neilextraacount-create/holoween-shoot/conveyor/simple/slice-report.md

# Slicer check, every part alone (PrusaSlicer engine, P2S-like profile)

| Part | Qty | Walls | Infill | g each | Time each | Slicer alerts |
|---|---|---|---|---|---|---|
| `head_frame` | 1 | 2 | 10 % | 124 | 3h 39m 44s | none |
| `drive_roller` | 1 | 2 | 10 % | 69 | 4h 10m 44s | none |
| `journal_pin` | 2 | 3 | 100 % | 5 | 16m 34s | none |
| `crank_gear` | 1 | 2 | 10 % | 18 | 38m 56s | none |
| `crank_arm` | 1 | 3 | 15 % | 34 | 1h 2m 1s | Floating object part, Floating bridge anchors |
| `crank_pin` | 1 | 3 | 100 % | 5 | 10m 27s | none |
| `tail_frame` | 1 | 2 | 10 % | 177 | 5h 12m 17s | Collapsing overhang, Thin fragile part |
| `tail_roller` | 1 | 2 | 10 % | 33 | 1h 15m 15s | Long bridging extrusions |
| `wedge` | 2 | 3 | 100 % | 13 | 14m 35s | none |
| `cassette` | 3 | 2 | 10 % | 64 | 1h 54m 37s | Low bed adhesion, Long bridging extrusions |
| `station_stake_1` | 1 | 3 | 15 % | 31 | 35m 37s | none |
| `station_stake_2` | 1 | 3 | 15 % | 29 | 33m 24s | none |
| `station_stake_3` | 1 | 3 | 15 % | 27 | 31m 11s | none |
| `anchor_stake` | 4 | 3 | 15 % | 25 | 32m 21s | none |

Whole machine: **0.87 kg**, about **27 h** (parts one at a time; plates save some time).
