neilextraacount-create/holoween-shoot/conveyor/cad/slice-report.md

# Slicer check (PrusaSlicer engine, P2S-like profile)

Generated by `cad/slice_all.py`. Each part sliced alone with its walls, infill and layer height;
brim 5 mm where the printing guide says. Alerts are the slicer's own stability analysis.

| Part | Qty | Layer | g each | Time each | Slicer alerts |
|---|---|---|---|---|---|
| `test_coupon` | 1 | 0.2 | 53 | 1h 30m 52s | Low bed adhesion, Loose extrusions |
| `wheel_unit` | 6 | 0.2 | 23 | 58m 31s | none |
| `station_bracket` | 3 | 0.2 | 15 | 23m 28s | none |
| `stake_1` | 1 | 0.2 | 34 | 37m 8s | Long bridging extrusions |
| `stake_2` | 1 | 0.2 | 32 | 34m 47s | Long bridging extrusions |
| `stake_3` | 1 | 0.2 | 29 | 32m 37s | Long bridging extrusions |
| `drive_roller` | 1 | 0.16 | 84 | 5h 3m 1s | none |
| `drive_pin` | 1 | 0.2 | 5 | 16m 34s | none |
| `head_side_a` | 1 | 0.2 | 45 | 1h 9m 30s | none |
| `head_side_b` | 1 | 0.2 | 54 | 1h 26m 4s | none |
| `gearbox` | 1 | 0.16 | 95 | 3h 18m 43s | Low bed adhesion |
| `trap` | 1 | 0.2 | 33 | 1h 18m 48s | none |
| `foot` | 3 | 0.2 | 23 | 36m 22s | none |
| `tail_side_l` | 1 | 0.2 | 44 | 1h 13m 37s | none |
| `tail_side_r` | 1 | 0.2 | 44 | 1h 12m 40s | none |
| `tail_roller` | 1 | 0.16 | 46 | 1h 33m 46s | Low bed adhesion |
| `takeup_block` | 2 | 0.2 | 13 | 25m 19s | none |
| `takeup_nut` | 2 | 0.2 | 2 | 5m 1s | none |
| `takeup_screw` | 2 | 0.2 | 12 | 50m 31s | none |
| `skid_l` | 1 | 0.2 | 32 | 48m 40s | none |
| `skid_r` | 1 | 0.2 | 32 | 48m 40s | none |
| `chute_segment` | 5 | 0.2 | 91 | 3h 8m 22s | none |
| `crank_head` | 1 | 0.2 | 116 | 3h 11m 26s | Low bed adhesion |
| `crank_arm` | 1 | 0.2 | 45 | 1h 29m 42s | Floating object part, Collapsing overhang |
| `pin3` | 12 | 0.2 | 0 | 1m 50s | none |
| `splice_template` | 1 | 0.2 | 13 | 27m 25s | none |
| `stand_shim` | 4 | 0.2 | 3 | 4m 25s | none |
| `hex_coupler` | 7 | 0.2 | 3 | 6m 8s | none |
| `ring_sleeve` | 6 | 0.2 | 2 | 3m 41s | none |
| `post_lower` | 1 | 0.2 | 46 | 53m 27s | Floating bridge anchors, Long bridging extrusions |
| `post_upper` | 1 | 0.2 | 35 | 51m 50s | none |
| `stand_tray` | 1 | 0.2 | 29 | 45m 32s | none |
| `ground_screw` | 4 | 0.2 | 24 | 1h 16m 40s | none |
| `spike` | 4 | 0.2 | 17 | 22m 3s | none |
| `stake_cap` | 1 | 0.2 | 6 | 16m 24s | none |
| `gs_wrench` | 1 | 0.2 | 21 | 35m 32s | none |
| `bolt8_28` | 17 | 0.2 | 2 | 14m 51s | none |
| `nut8` | 13 | 0.2 | 1 | 3m 31s | none |
| `washer50` | 4 | 0.2 | 7 | 8m 9s | none |

Machine total (test coupon excluded): **1.97 kg**, about **70 h** of printing (PrusaSlicer's estimate with Bambu-like speeds; parts sliced one at a time, so plates of several parts save some time).
