neilextraacount-create/holoween-shoot/conveyor/calc/report-2-risers.txt

==============================================================================
CANDY CONVEYOR v4 (all printed except the belt) - 2 risers x 7.00 in (riser height ASSUMED)
==============================================================================
Porch floor 35.9 in above the sidewalk; lawn rises 21.9 in over 250 in
Belt: drive roller at x=240 in (10 in before the first riser), belt top 6.0 in above the lawn
      tail roller at x=-2 in (over the sidewalk), belt top 9.0 in -> basket rim <= 6.0 in
      slope 4.25 deg; axle to axle 6164 mm (20.22 ft)

STAKE STATIONS (3, every 60.5 in)
   #    x in  ground  belt top  stake head  stake length  stake_len (leg)
   1    58.5     5.1       8.4       5.1 in       280 mm          248 mm  (STL: stake_1)
   2   119.0    10.4       7.6       4.3 in       260 mm          228 mm  (STL: stake_2)
   3   179.5    15.7       6.8       3.5 in       240 mm          208 mm  (STL: stake_3)
  -> stake_len = [248, 228, 208] in params.scad (leg lengths; each stake is 32 mm longer overall)

DRIVE LINE (chute + shaft) at 40.3 deg to level, from the drive axle up to the porch
  4 segments: crank 18.2 in above the porch floor, +3.6 in behind the edge; stand post -2.7 in behind the edge
  5 segments: crank 23.6 in above the porch floor, +9.9 in behind the edge; stand post +3.6 in behind the edge  <- use
  6 segments: crank 28.9 in above the porch floor, +16.2 in behind the edge; stand post +9.9 in behind the edge
  7 segments: crank 34.2 in above the porch floor, +22.5 in behind the edge; stand post +16.2 in behind the edge
  8 segments: crank 39.6 in above the porch floor, +28.8 in behind the edge; stand post +22.5 in behind the edge
  9 segments: crank 44.9 in above the porch floor, +35.1 in behind the edge; stand post +28.8 in behind the edge
  underside over riser 1 top (x=250): 4.4 in
  underside over riser 2 top (x=270): 14.4 in
  -> minimum clearance 4.4 in OK
  porch stand: post 3.6 in behind the porch edge; socket mouth 552 mm above the porch floor -> stand_h = 552 in params.scad

BELT (3 in heavy polypropylene webbing, Country Brook 50 yd)
  Loop about 12493 mm = 41.0 ft; cut 43 ft and sew in place with a 75 mm lap

LOADS (estimates; PLA-on-PLA plain bearings)
  dry PLA  : tail bearing  6.6 N + 6 wheels 1.8 N + bending 2 N = 10.4 N belt drag; slack side 14.8 N; drive needs mu >= 0.17; crank 1.26 N.m = 11 N (2.6 lbf)
  waxed PLA: tail bearing  3.7 N + 6 wheels 1.0 N + bending 2 N =  6.8 N belt drag; slack side 16.6 N; drive needs mu >= 0.11; crank 0.96 N.m = 9 N (2.0 lbf)
  Ribbed PLA on dry webbing is roughly mu 0.3, wet roughly 0.2: grip is adequate; wax the bearings.
  Carrying-run sag between stations (1.54 m, 15 N): light candy 22 mm
  Carrying-run sag between stations (1.54 m, 15 N): dense candy 41 mm
  Tension test, 100 g laid across the belt midway between stations: extra dip 13-15 mm at 25 N, 15-18 mm at 20 N, 17-22 mm at 15 N per run -> target 13-22 mm
  Gap between the top and return runs at a station: 44.6 mm; with dense candy at mid-span about 12 mm
  Crank 45 rpm x 2 -> belt 0.30 m/s; candy rides the belt in 21 s (15 turns)
  Candy leaves a 1.16 m chute at 3.1 m/s (wrapper friction 0.3); the drop trap at the bottom stops it
  Candy leaves a 1.16 m chute at 2.6 m/s (wrapper friction 0.45); the drop trap at the bottom stops it

ANCHORING (belt tension must go into the ground at both ends)
  tail: 40 N pull at 207 mm -> 8.3 N.m; tipping arm 172 mm -> 48 N uplift on the 2 skid anchors nearest the sidewalk (ground screws): 24 N each, or 4.9 kg of ballast against tipping
  head: 40 N pull at 120 mm -> 4.8 N.m; tipping arm 170 mm -> 28 N uplift on the 2 anchors of the foot nearest the steps (ground screws): 14 N each, or 2.9 kg of ballast against tipping
  sliding with ballast only (nothing in the ground; wet grass mu 0.4): head needs 13 kg, tail 8 kg in total -> the ground screws (or spikes) must hold the 40 N; ballast only helps against tipping

PLA STRESS CHECKS (parts printed with layers across the load are the weak case; only the printed walls
  count: 3 walls = a 1.26 mm solid shell on rollers and the gearbox, 2 walls = 0.84 mm on the chute's shaft;
  the 10 % sparse infill inside is ignored)
  tail axle Ø12 (layers across, shell only): 8.7 MPa bending  (PLA interlayer ~20-30 MPa)
  torque path, shear in MPa at the dry crank torque 1.26 / 2x 2.52 / a 30 N yank 3.30 N.m (PLA across layers ~20-30):
    line shaft tube Ø18/10             2.7 /   5.4 /   7.1
    hex coupler 11 mm across flats     5.0 /  10.1 /  13.2
    square drive 12.4 mm               4.0 /   8.1 /  10.6
  gear teeth at 2x dry torque: 45 N tooth force -> 7.6 MPa (Lewis); crown teeth are printed with layers across
  porch stand: about 7 N.m tips the stand sideways when cranking hard -> tie the post to a railing, or about 8 kg on the tray (two 1-gallon water jugs), or hold the funnel rim
  station wheel axle Ø11 (2-wall shell only), 6 N at mid-wheel: 4.8 MPa bending across layers
  crank grip axle Ø13 with a 30 N hand load at mid-grip: 4.9 MPa bending across layers
  crank arm 14 x 7 mm at the hub, 30 N on the grip: 12.7 MPa bending along the layers (PLA ~50)
