neilextraacount-create/holoween-shoot/conveyor/simple/gcode-gaps.md

# Print-in-place gaps in the sliced G-code

| Part | Bodies | Smallest side gap | Printed over another body |
|---|---|---|---|
| `crank_arm` | 2 | 0.43 mm | 2 layer(s) of air |
| `cassette` | 3 | 0.44 mm | never |

Result: all gaps open.
