neilextraacount-create/holoween-shoot/conveyor/plates/plates.md

# Print plates

Generated by `cad/make_plates.py`. Start each plate in a new project (File > New Project) and import
the plate file: Bambu Studio centres an imported plate on the bed and does not move it clear of parts
already there. Choose the P2S, 0.4 mm nozzle, your PLA and the textured PEI plate, set the plate's
walls, infill, layer height and brim as listed, then slice and print.
Grams and times are PrusaSlicer's estimate with a P2S-like profile; Bambu Studio's numbers will differ a little.

| # | File | Parts | For | Settings | g | Time |
|---|---|---|---|---|---|---|
| 1 | `FINAL_01_test_coupon_etc.3mf` | `test_coupon`, `hex_coupler`, `ring_sleeve`, `bolt8_28`, `stake_cap` | test | 3 walls, 15 % | 64 | 1h 53m 47s |
| 2 | `FINAL_02_bolt8_28_etc.3mf` | 7 x `hex_coupler`, 17 x `bolt8_28`, 12 x `pin3`, 2 x `takeup_screw` | head, tail | 3 walls, 100 %, 5 mm brim | 90 | 3h 22m 27s |
| 3 | `FINAL_03_washer50_etc.3mf` | `drive_pin`, 6 x `ring_sleeve`, 13 x `nut8`, 2 x `takeup_block`, 2 x `takeup_nut`, 4 x `washer50`, 4 x `stand_shim`, `splice_template` | head, tail, anchors, porch stand, belt joint | 3 walls, 100 % | 111 | 3h 12m 56s |
| 4 | `FINAL_04_head_side_a_etc.3mf` | `head_side_a`, 2 x `foot`, `station_bracket` | head, station 1 | 3 walls, 12 % | 105 | 2h 46m 20s |
| 5 | `FINAL_05_gearbox_etc.3mf` | `gearbox`, `drive_roller`, `tail_roller` | head, tail | 3 walls, 10 %, 0.16 mm layers | 224 | 9h 58m 22s |
| 6 | `FINAL_06_head_side_b_etc.3mf` | `head_side_b`, `foot`, `spike` | head, tail | 3 walls, 12 % | 94 | 2h 24m 13s |
| 7 | `FINAL_07_wheel_unit.3mf` | 6 x `wheel_unit` | station 1 | 2 walls, 10 %, 5 mm brim | 136 | 4h 26m 38s |
| 8 | `FINAL_08_tail_side_r_etc.3mf` | `station_bracket`, `tail_side_r`, 3 x `spike` | station 1, tail | 3 walls, 12 % | 109 | 2h 31m 20s |
| 9 | `FINAL_09_post_lower_etc.3mf` | `stake_1`, `stake_2`, `post_lower` | station 1, stations 2-3, porch stand | 3 walls, 12 % | 112 | 2h 6m 30s |
| 10 | `FINAL_10_tail_side_l_etc.3mf` | `station_bracket`, `tail_side_l` | station 1, tail | 3 walls, 12 % | 59 | 1h 35m 50s |
| 11 | `FINAL_11_crank_arm_etc.3mf` | `stake_cap`, `crank_arm` | station 1, chute line | 4 walls, 30 % | 52 | 1h 42m 56s |
| 12 | `FINAL_12_skid_l_etc.3mf` | `skid_l`, `skid_r` | tail | 3 walls, 12 % | 64 | 1h 37m 28s |
| 13 | `FINAL_13_gs_wrench_etc.3mf` | `gs_wrench`, 4 x `ground_screw` | anchors | 3 walls, 15 %, 5 mm brim | 116 | 4h 48m 44s |
| 14 | `FINAL_14_post_upper_etc.3mf` | `stake_3`, `post_upper` | stations 2-3, porch stand | 3 walls, 12 % | 64 | 1h 24m 16s |
| 15 | `FINAL_15_chute_segment_etc.3mf` | `trap`, 3 x `chute_segment` | chute line | 2 walls, 10 %, 5 mm brim | 306 | 9h 58m 48s |
| 16 | `FINAL_16_chute_segment.3mf` | 2 x `chute_segment` | chute line | 2 walls, 10 %, 5 mm brim | 182 | 6h 7m 40s |
| 17 | `FINAL_17_crank_head.3mf` | `crank_head` | chute line | 3 walls, 10 %, 5 mm brim | 116 | 3h 11m 21s |
| 18 | `FINAL_18_stand_tray.3mf` | `stand_tray` | porch stand | 3 walls, 12 % | 29 | 45m 34s |

All plates: **2.03 kg** of filament (test coupon plate included).
