neilextraacount-create/holoween-shoot/conveyor/cad/gcode-gaps.md

# Print-in-place gaps in the sliced G-code

Generated by `cad/gcode_gaps.py` from the G-code `slice_all.py` writes. Side gap: the closest
approach of plastic of two different bodies in one layer (lines counted at their full width).
Vertical: a body printed over another one 1 layer below (fused), 2 layers below (0.2 mm of air)
or 3 layers below (0.4 mm).

| Part | Bodies | Smallest side gap | Printed over another body |
|---|---|---|---|
| `test_coupon` | 7 | 0.34 mm (z 2.6) | 2 layer(s) of air at z 4.6 |
| `wheel_unit` | 2 | 0.44 mm (z 58.2) | never |
| `gearbox` | 2 | 0.43 mm (z 15.08) | never |
| `tail_roller` | 2 | 0.44 mm (z 61.48) | never |
| `chute_segment` | 2 | 0.44 mm (z 167.4) | never |
| `crank_head` | 2 | 0.44 mm (z 117.0) | never |
| `crank_arm` | 2 | 0.43 mm (z 7.6) | 2 layer(s) of air at z 7.6 |

Result: all gaps open (side gap must be >= 0.30 mm, nothing printed directly on another body).
