neilextraacount-create/holoween-shoot/conveyor/cad/parts-table.md

| Part (STL) | Qty | Size on the bed, mm | Walls | Infill | Layer | Brim | ~g each (mesh estimate) | What it is |
|---|---|---|---|---|---|---|---|---|
| `test_coupon` | 1 | 150 x 93 x 20 | 3 | 15 % | 0.20 | no | 60 | PRINT FIRST: fit ladder (spinners 0.35/0.45/0.55, sockets, M8 nut) |
| `wheel_unit` | 6 | 30 x 30 x 115 | 2 | 10 % | 0.20 | 5 mm | 21 | station wheel, print-in-place (2 per station) |
| `station_bracket` | 3 | 28 x 109 x 16 | 3 | 12 % | 0.20 | no | 17 | station bracket (holds 2 wheels on the stake) |
| `stake_1` | 1 | 214 x 200 x 22 (diagonal) | 3 | 12 % | 0.20 | no | 37 | station 1 stake (nearest the sidewalk) |
| `stake_2` | 1 | 199 x 186 x 22 (diagonal) | 3 | 12 % | 0.20 | no | 35 | station 2 stake |
| `stake_3` | 1 | 185 x 171 x 22 (diagonal) | 3 | 12 % | 0.20 | no | 32 | station 3 stake |
| `drive_roller` | 1 | 67 x 67 x 122 | 3 | 10 % | 0.16 | no | 93 | drive roller with 17T pinion |
| `drive_pin` | 1 | 20 x 20 x 35 | 3 | 100 % | 0.20 | no | 5 | drive roller A-side journal pin (press in) |
| `head_side_a` | 1 | 206 x 196 x 6 | 3 | 12 % | 0.20 | no | 57 | head side frame A (round journal hole) |
| `head_side_b` | 1 | 237 x 196 x 6 | 3 | 12 % | 0.20 | no | 68 | head side frame B (open journal slot, gearbox mount) |
| `gearbox` | 1 | 92 x 109 x 91 | 3 | 10 % | 0.16 | no | 96 | gearbox: 34T crown gear rotor in its housing, print-in-place |
| `trap` | 1 | 103 x 37 x 152 | 2 | 10 % | 0.20 | 5 mm | 32 | drop trap (bottom of the chute, rests on the head frames) |
| `foot` | 3 | 36 x 196 x 24 | 3 | 12 % | 0.20 | no | 25 | foot crossbar (2 head, 1 tail rear) |
| `tail_side_l` | 1 | 227 x 218 x 28 | 3 | 12 % | 0.20 | no | 54 | tail side frame, left (-Y) |
| `tail_side_r` | 1 | 227 x 218 x 28 | 3 | 12 % | 0.20 | no | 54 | tail side frame, right (+Y) |
| `tail_roller` | 1 | 45 x 45 x 90 | 3 | 10 % | 0.16 | no | 46 | tail roller, print-in-place |
| `takeup_block` | 2 | 22 x 24 x 36 | 3 | 100 % | 0.20 | no | 13 | take-up block (one per side) |
| `takeup_nut` | 2 | 16 x 16 x 8 | 3 | 100 % | 0.20 | no | 2 | take-up square nut |
| `takeup_screw` | 2 | 21 x 22 x 108 | 3 | 100 % | 0.20 | 5 mm | 11 | take-up screw with knob |
| `skid_l` | 1 | 239 x 59 x 24 | 3 | 12 % | 0.20 | no | 37 | tail skid, left |
| `skid_r` | 1 | 239 x 59 x 24 | 3 | 12 % | 0.20 | no | 37 | tail skid, right |
| `chute_segment` | 5 | 166 x 136 x 230 | 2 | 10 % | 0.20 | 5 mm | 113 | chute segment with print-in-place drive shaft |
| `crank_head` | 1 | 185 x 156 x 180 | 3 | 10 % | 0.20 | 5 mm | 142 | crank head: funnel + crank shaft, print-in-place |
| `crank_arm` | 1 | 134 x 26 x 77 | 4 | 30 % | 0.20 | no | 49 | crank arm with spinning grip, print-in-place |
| `pin3` | 12 | 28 x 7 x 5 | 3 | 100 % | 0.20 | 5 mm | 0 | 3 mm pin: wheel pegs (6), crank arm, crank-head socket, stand height, tray, joint between 2 lower posts if any, spares (2) |
| `splice_template` | 1 | 78 x 82 x 6 | 3 | 100 % | 0.20 | no | 13 | belt sewing template (box-and-X hole pattern) |
| `stand_shim` | 4 | 40 x 22 x 3 | 3 | 100 % | 0.20 | no | 3 | shims to level the porch stand foot |
| `hex_coupler` | 7 | 23 x 13 x 11 | 3 | 100 % | 0.20 | 5 mm | 3 | hex coupler between shafts |
| `ring_sleeve` | 6 | 25 x 25 x 8 | 3 | 100 % | 0.20 | no | 2 | sleeve between bearing rings |
| `post_lower` | 1 | 229 x 233 x 22 (diagonal) | 3 | 12 % | 0.20 | no | 51 | porch stand post, lower |
| `post_upper` | 1 | 226 x 226 x 20 (diagonal) | 3 | 12 % | 0.20 | no | 40 | porch stand post, upper |
| `stand_tray` | 1 | 190 x 236 x 32 | 3 | 12 % | 0.20 | no | 34 | porch stand foot (put the candy bowl on it) |
| `ground_screw` | 4 | 26 x 26 x 150 | 3 | 15 % | 0.20 | 5 mm | 24 | ground screw (head front foot, tail skid rear anchors) |
| `spike` | 4 | 134 x 30 x 30 | 3 | 12 % | 0.20 | no | 18 | L spike with nail head: 2 for the tail skid far pads, 2 optional for the head rear foot |
| `stake_cap` | 1 | 22 x 22 x 28 | 4 | 30 % | 0.20 | no | 8 | push the stakes in through this cap |
| `gs_wrench` | 1 | 160 x 33 x 24 | 3 | 15 % | 0.20 | 5 mm | 23 | T-wrench for the ground screws |
| `bolt8_28` | 17 | 13 x 15 x 33 | 3 | 100 % | 0.20 | 5 mm | 2 | printed M8 bolt (13 frame joints + 4 ground screws) |
| `nut8` | 13 | 13 x 15 x 7 | 3 | 100 % | 0.20 | no | 1 | printed M8 nut |
| `washer50` | 4 | 50 x 50 x 3 | 3 | 100 % | 0.20 | no | 7 | 50 mm washer over a ground screw |

Filament for one machine (test coupon excluded): **about 2.20 kg** (estimate from the meshes; your slicer gives the real number).
