neilextraacount-create/holoween-shoot/conveyor/cad/stl/spike.stl

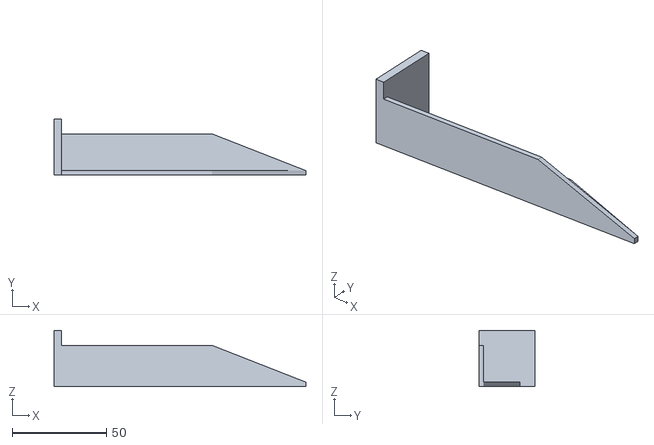
[picture p10: CAD file, 2026-10-14]
conveyor/cad/stl/spike.stl
134.0 x 30.0 x 30.0
