neilextraacount-create/holoween-shoot/conveyor/plates/FINAL_08_tail_side_r_etc.3mf

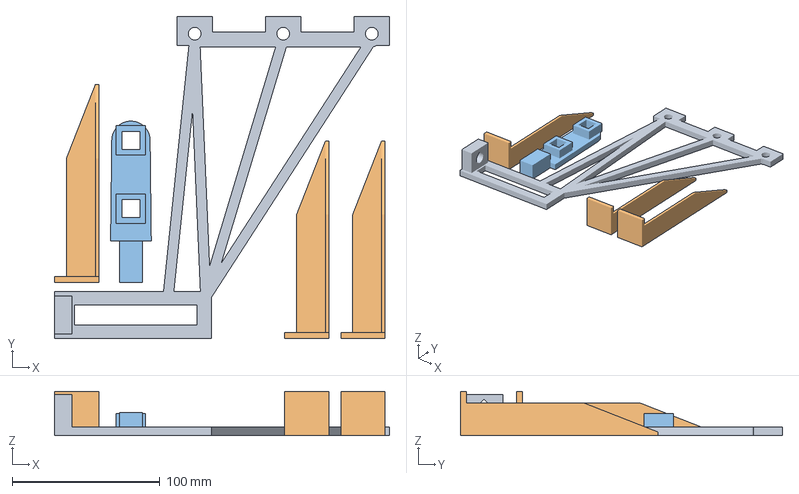
[picture p11: CAD file, 2026-10-14]
conveyor/plates/FINAL_08_tail_side_r_etc.3mf
227.0 x 218.2 x 30.0 mm
tail_side_r
spike x 3
station_bracket
