neilextraacount-create/holoween-shoot/conveyor/simple/plates/SIMPLE_03_head_frame.3mf

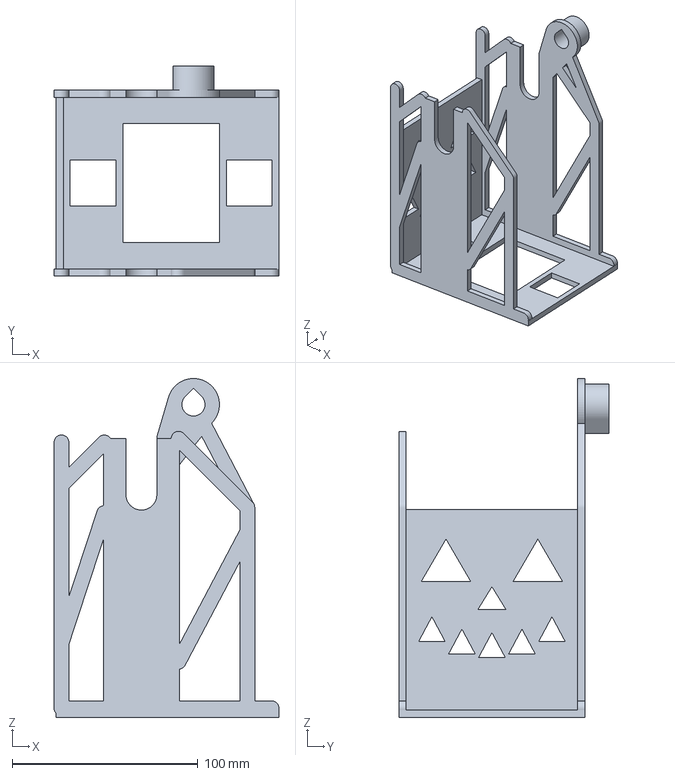
[picture p12: CAD file, 2026-10-16]
conveyor/simple/plates/SIMPLE_03_head_frame.3mf
121.0 x 113.2 x 182.4 mm
