neilextraacount-create/holoween-shoot/conveyor/cad/stl/stake_3.stl

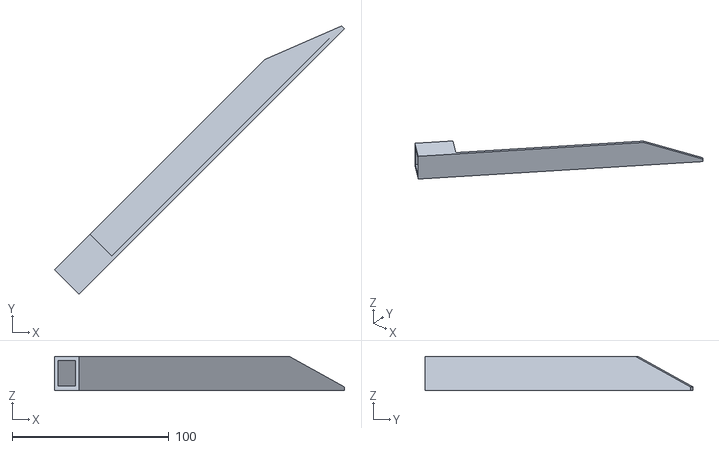
[picture p13: CAD file, 2026-10-14]
conveyor/cad/stl/stake_3.stl
185.3 x 171.4 x 22.0
