neilextraacount-create/holoween-shoot/conveyor/plates/FINAL_17_crank_head.3mf

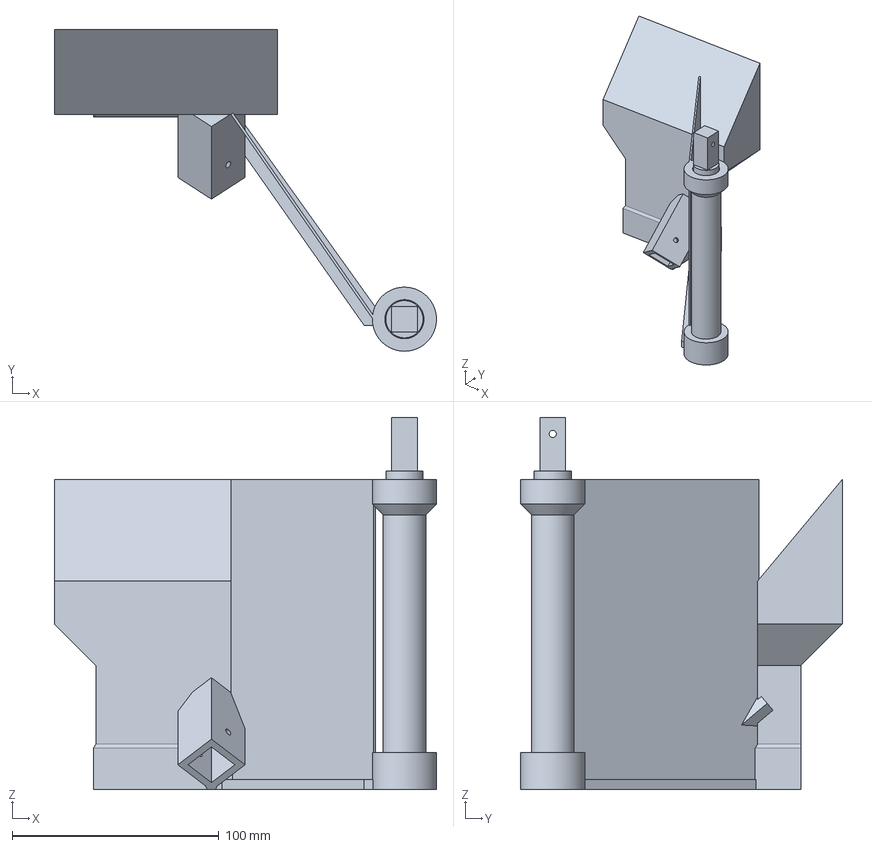
[picture p14: CAD file, 2026-10-14]
conveyor/plates/FINAL_17_crank_head.3mf
184.8 x 155.5 x 180.0 mm
