neilextraacount-create/holoween-shoot/conveyor/simple/plates/SIMPLE_04_cassette_etc.3mf

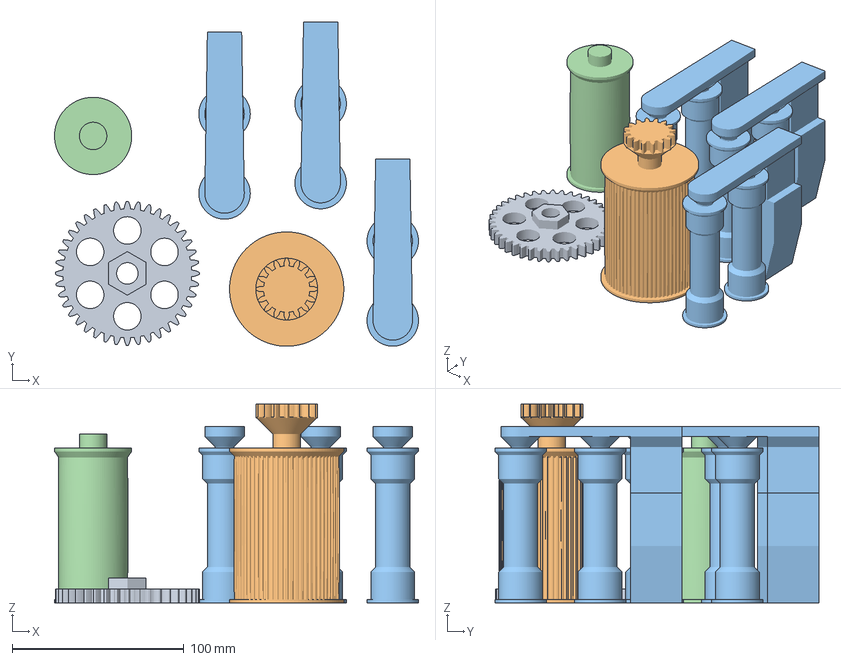
[picture p15: CAD file, 2026-10-16]
conveyor/simple/plates/SIMPLE_04_cassette_etc.3mf
212.1 x 189.0 x 115.7 mm
crank_gear
drive_roller
cassette x 3
tail_roller
