neilextraacount-create/holoween-shoot/conveyor/simple/stl/wedge.stl

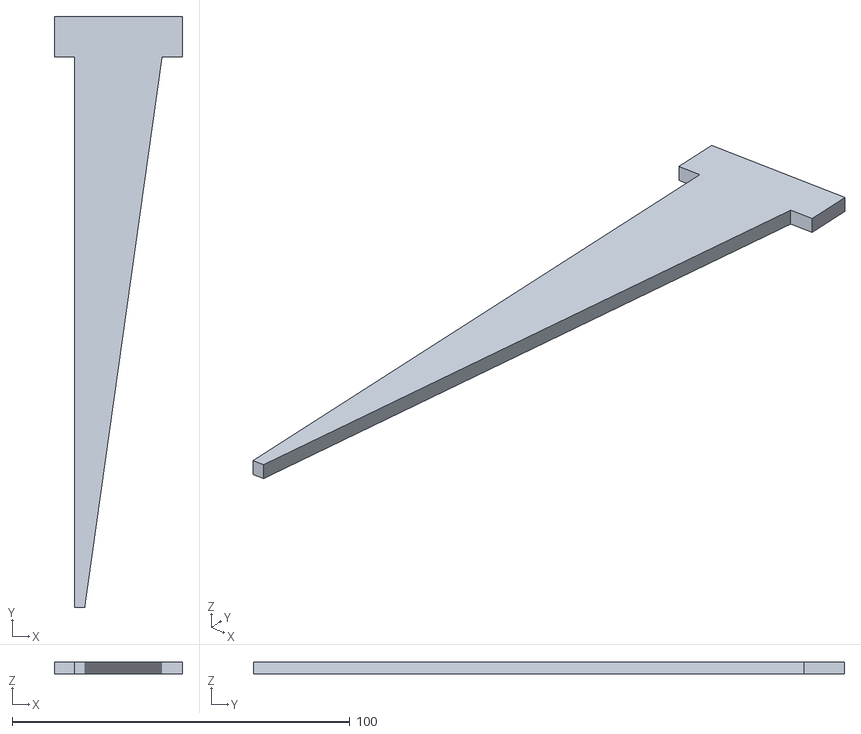
[picture p16: CAD file, 2026-10-16]
conveyor/simple/stl/wedge.stl
38.0 x 175.0 x 3.60
