neilextraacount-create/holoween-shoot/conveyor/plates/FINAL_09_post_lower_etc.3mf

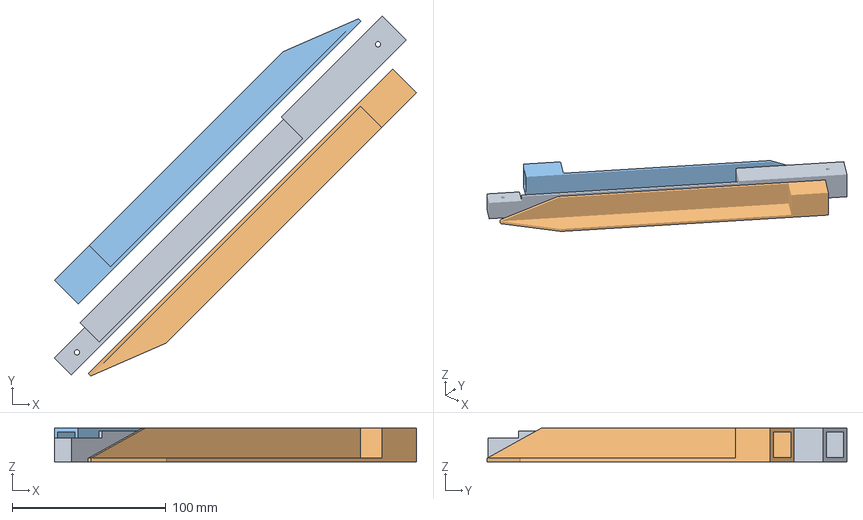
[picture p17: CAD file, 2026-10-14]
conveyor/plates/FINAL_09_post_lower_etc.3mf
235.6 x 234.0 x 22.0 mm
post_lower
stake_1
stake_2
