neilextraacount-create/holoween-shoot/conveyor/simple/plates/SIMPLE_01_wedge_etc.3mf

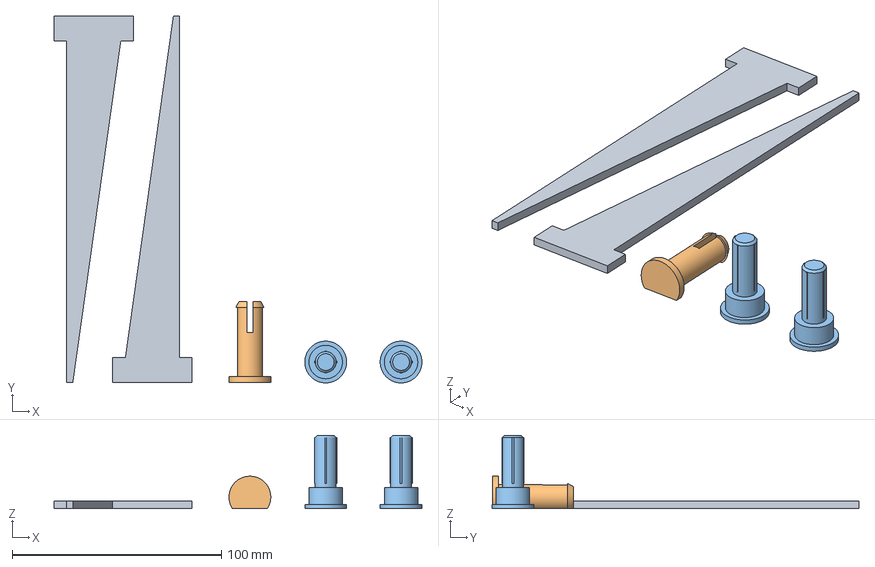
[picture p18: CAD file, 2026-10-16]
conveyor/simple/plates/SIMPLE_01_wedge_etc.3mf
175.8 x 175.3 x 35.0 mm
wedge x 2
crank_pin
journal_pin x 2
