neilextraacount-create/holoween-shoot/conveyor/simple/stl/cassette.stl

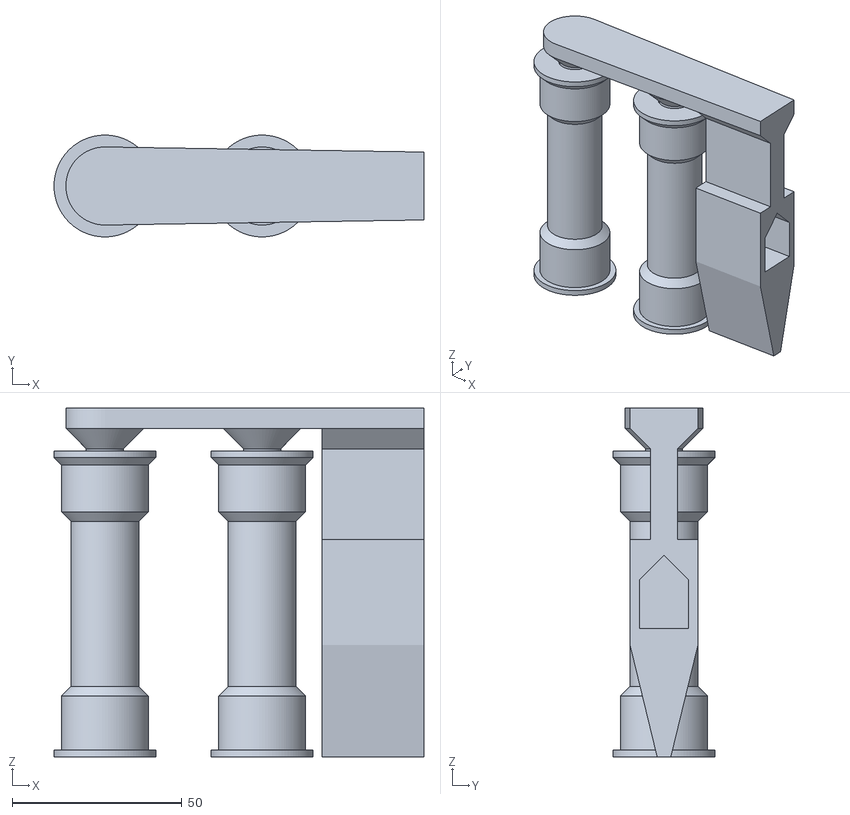
[picture p19: CAD file, 2026-10-16]
conveyor/simple/stl/cassette.stl
109.0 x 30.0 x 102.8
