neilextraacount-create/holoween-shoot/conveyor/cad/stl/crank_arm.stl

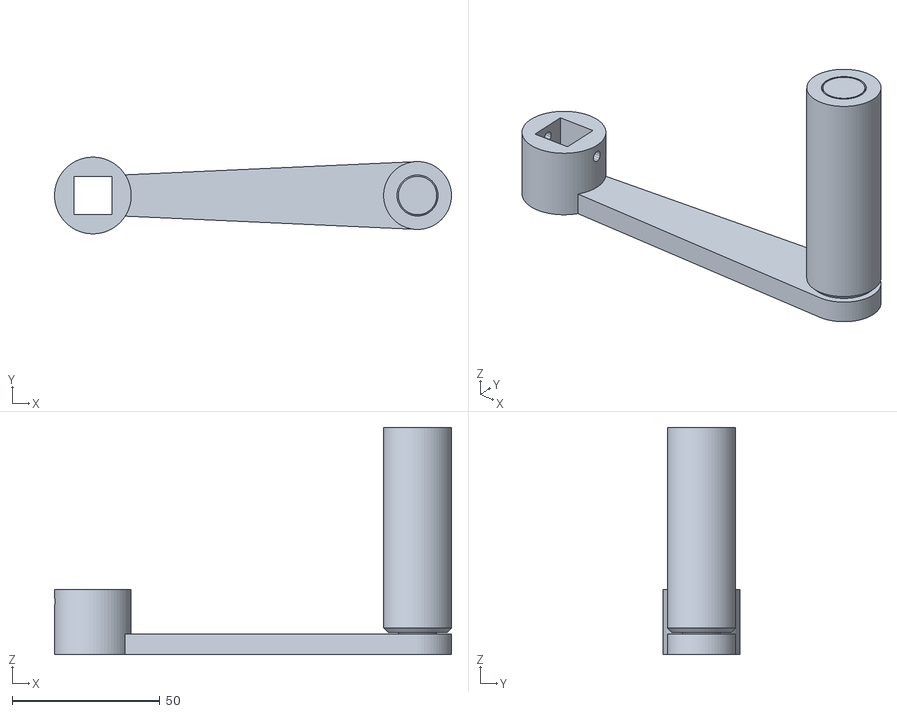
[picture p20: CAD file, 2026-10-14]
conveyor/cad/stl/crank_arm.stl
134.5 x 26.0 x 77.0
