neilextraacount-create/holoween-shoot/conveyor/plates/FINAL_10_tail_side_l_etc.3mf

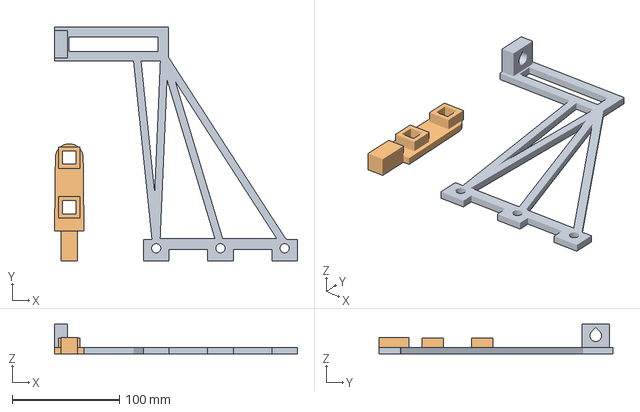
[picture p21: CAD file, 2026-10-14]
conveyor/plates/FINAL_10_tail_side_l_etc.3mf
227.0 x 218.2 x 28.0 mm
tail_side_l
station_bracket
