neilextraacount-create/holoween-shoot/conveyor/simple/plates/SIMPLE_02_tail_frame.3mf

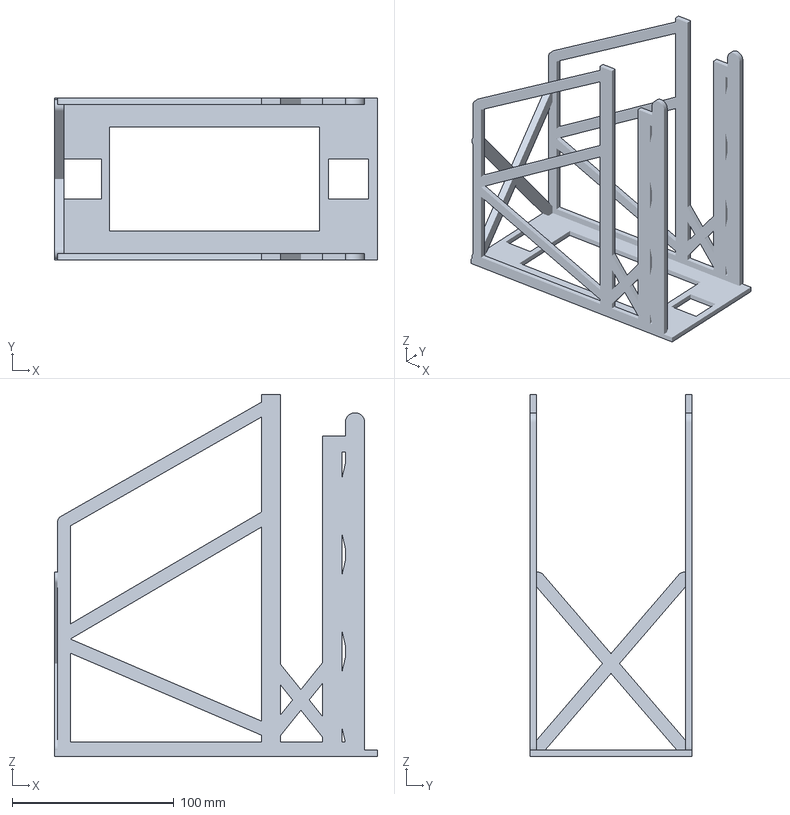
[picture p22: CAD file, 2026-10-16]
conveyor/simple/plates/SIMPLE_02_tail_frame.3mf
200.0 x 100.2 x 223.9 mm
