neilextraacount-create/holoween-shoot/conveyor/cad/stl/stake_1.stl

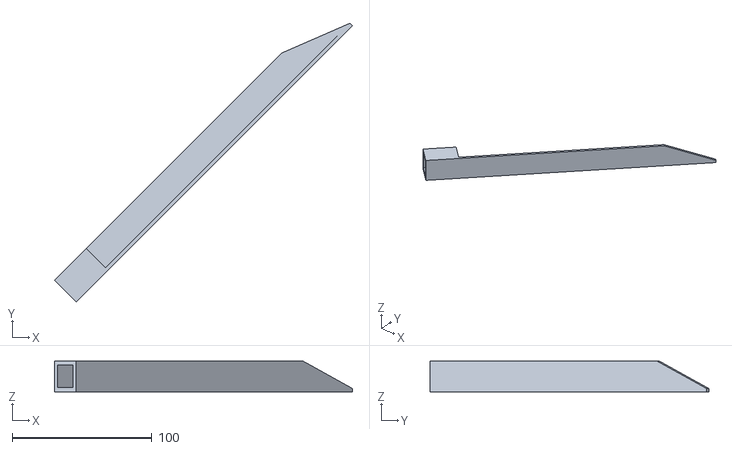
[picture p23: CAD file, 2026-10-14]
conveyor/cad/stl/stake_1.stl
213.5 x 199.7 x 22.0
