neilextraacount-create/holoween-shoot/conveyor/plates/FINAL_16_chute_segment.3mf

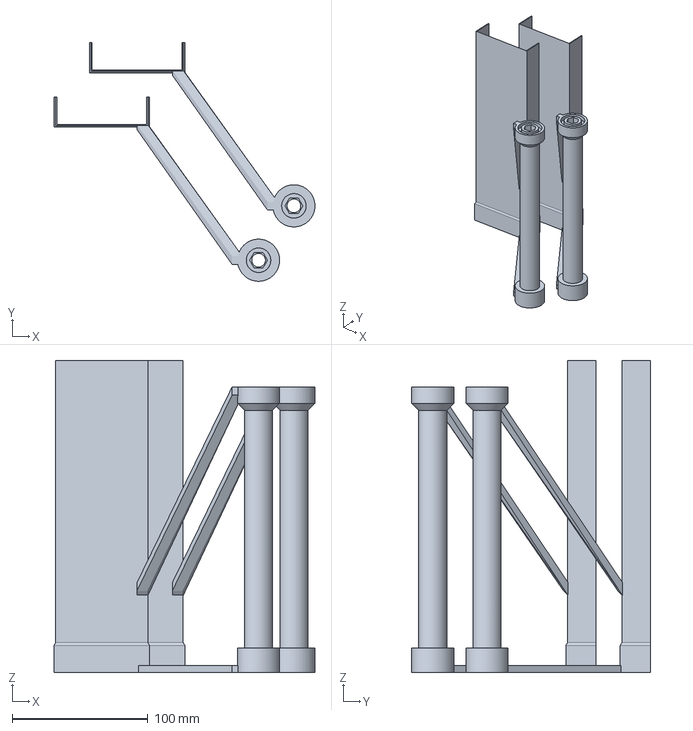
[picture p24: CAD file, 2026-10-14]
conveyor/plates/FINAL_16_chute_segment.3mf
191.9 x 175.5 x 229.5 mm
chute_segment x 2
