neilextraacount-create/holoween-shoot/conveyor/simple/plates/SIMPLE_06_anchor_stake.3mf

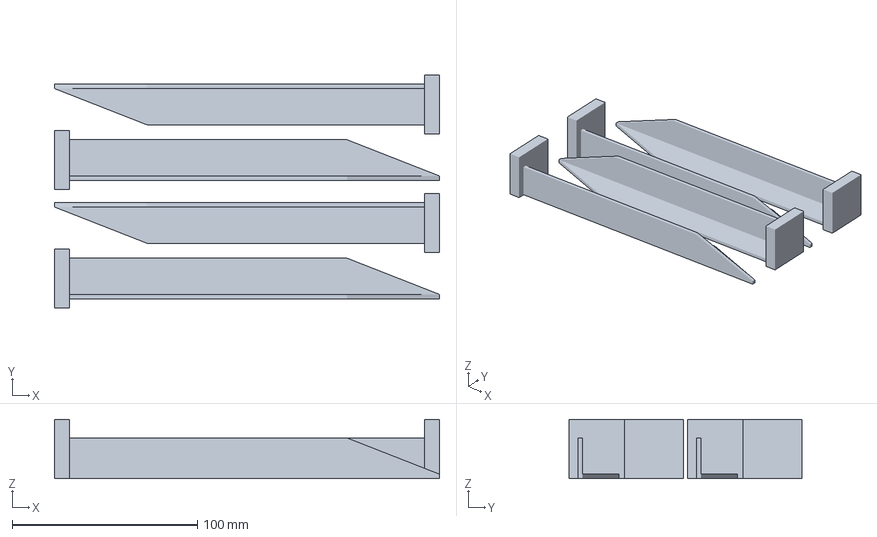
[picture p25: CAD file, 2026-10-15]
conveyor/simple/plates/SIMPLE_06_anchor_stake.3mf
208.0 x 126.0 x 32.0 mm
anchor_stake x 4
