neilextraacount-create/holoween-shoot/conveyor/simple/stl/anchor_stake.stl

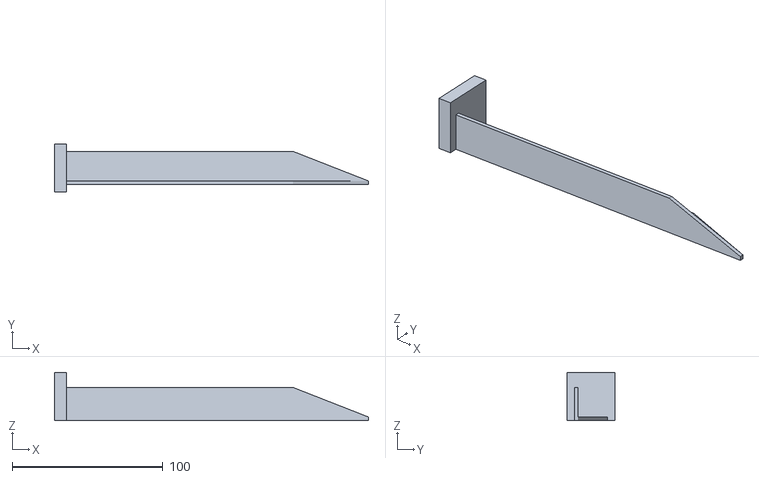
[picture p26: CAD file, 2026-10-15]
conveyor/simple/stl/anchor_stake.stl
208.0 x 32.0 x 32.0
