neilextraacount-create/holoween-shoot/conveyor/cad/stl/gearbox.stl

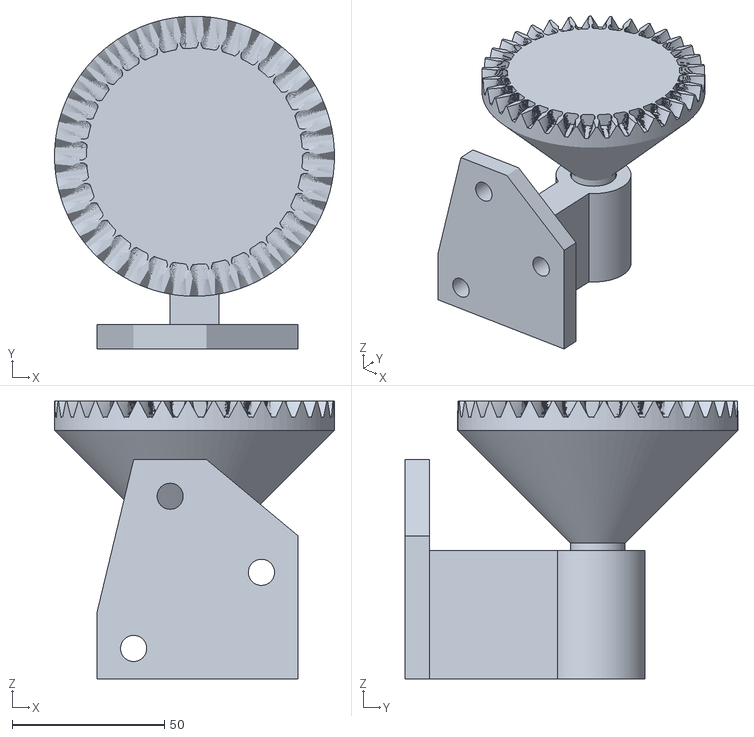
[picture p27: CAD file, 2026-10-14]
conveyor/cad/stl/gearbox.stl
92.0 x 109.2 x 91.2
