neilextraacount-create/holoween-shoot/conveyor/plates/FINAL_15_chute_segment_etc.3mf

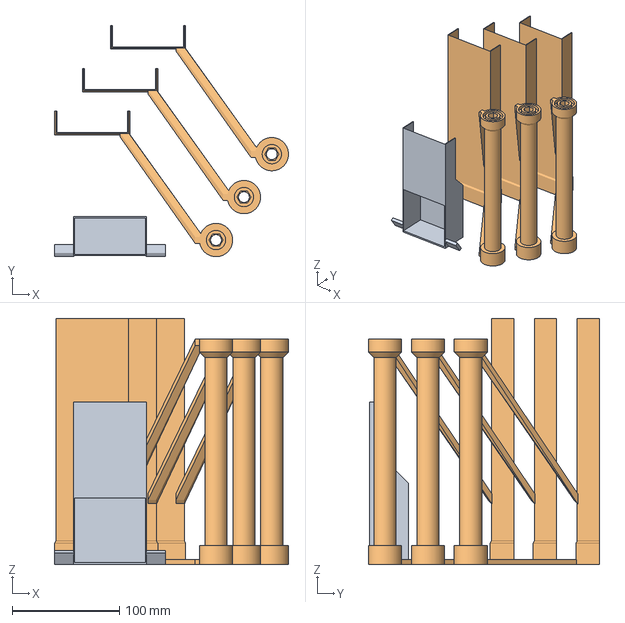
[picture p28: CAD file, 2026-10-14]
conveyor/plates/FINAL_15_chute_segment_etc.3mf
217.9 x 215.5 x 229.5 mm
trap
chute_segment x 3
