neilextraacount-create/holoween-shoot/conveyor/simple/plates/SIMPLE_05_station_stake_1_etc.3mf

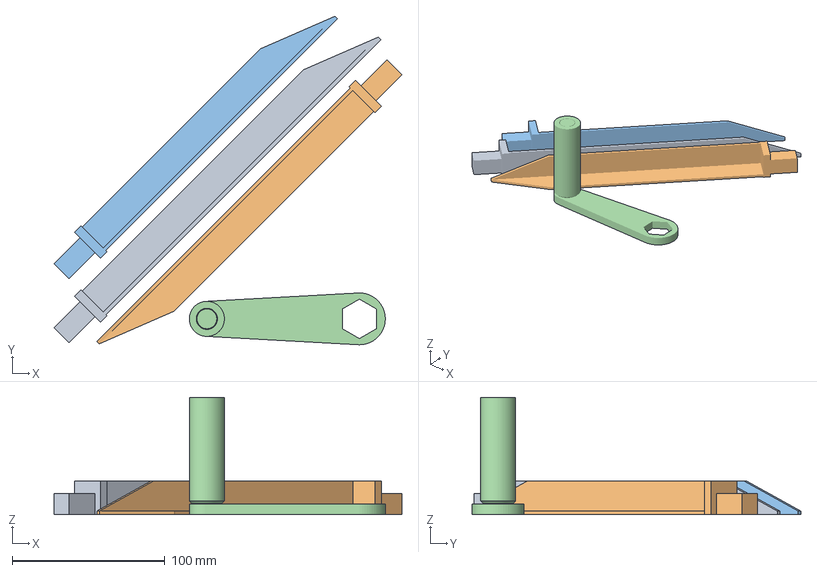
[picture p29: CAD file, 2026-10-15]
conveyor/simple/plates/SIMPLE_05_station_stake_1_etc.3mf
228.1 x 215.4 x 77.0 mm
station_stake_1
station_stake_2
station_stake_3
crank_arm
