neilextraacount-create/holoween-shoot/conveyor/simple/stl/crank_arm.stl

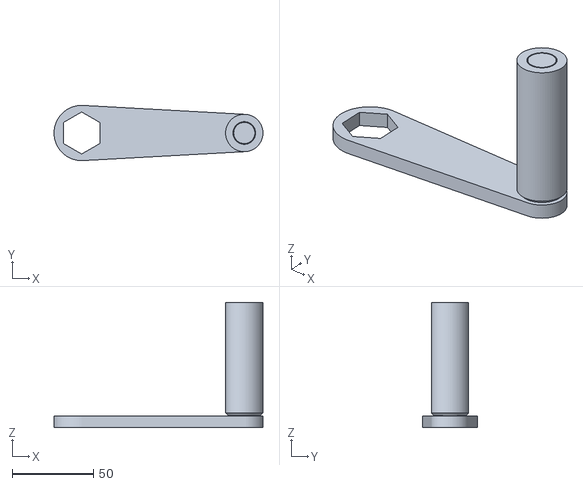
[picture p30: CAD file, 2026-10-15]
conveyor/simple/stl/crank_arm.stl
128.5 x 34.0 x 77.0
