neilextraacount-create/holoween-shoot/conveyor/cad/stl/chute_segment.stl

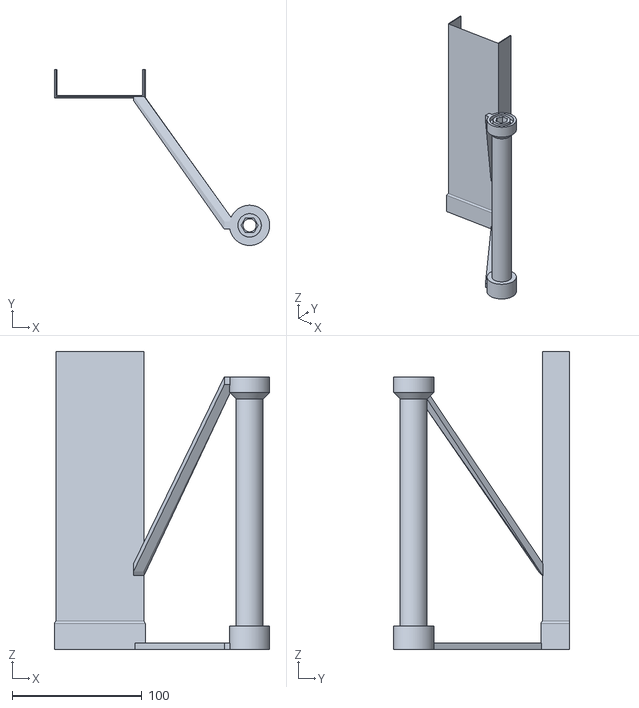
[picture p31: CAD file, 2026-10-14]
conveyor/cad/stl/chute_segment.stl
165.9 x 135.5 x 229.5
