neilextraacount-create/holoween-shoot/conveyor/plates/FINAL_11_crank_arm_etc.3mf

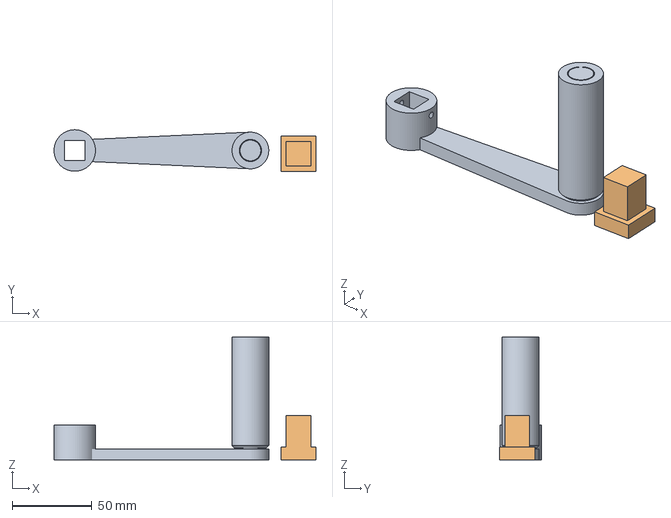
[picture p32: CAD file, 2026-10-14]
conveyor/plates/FINAL_11_crank_arm_etc.3mf
164.0 x 26.0 x 77.0 mm
crank_arm
stake_cap
