neilextraacount-create/holoween-shoot/conveyor/simple/stl/station_stake_2.stl

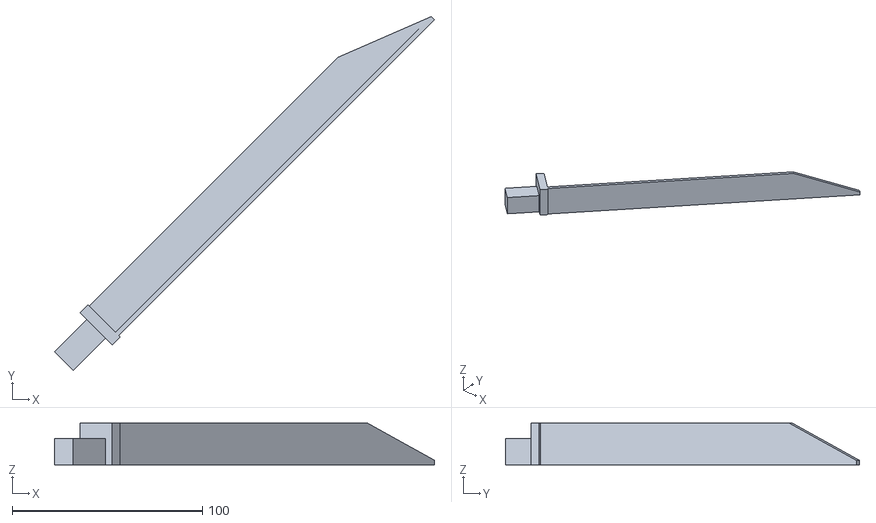
[picture p33: CAD file, 2026-10-15]
conveyor/simple/stl/station_stake_2.stl
200.1 x 186.3 x 22.0
