neilextraacount-create/holoween-shoot/conveyor/cad/stl/drive_roller.stl

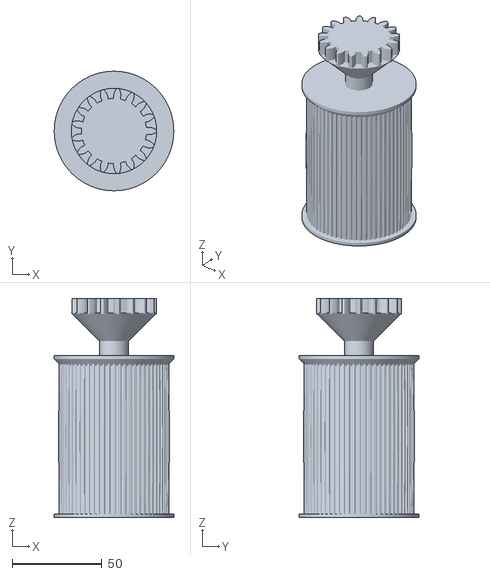
[picture p34: CAD file, 2026-10-14]
conveyor/cad/stl/drive_roller.stl
66.6 x 66.6 x 121.9
