neilextraacount-create/holoween-shoot/conveyor/plates/FINAL_06_head_side_b_etc.3mf

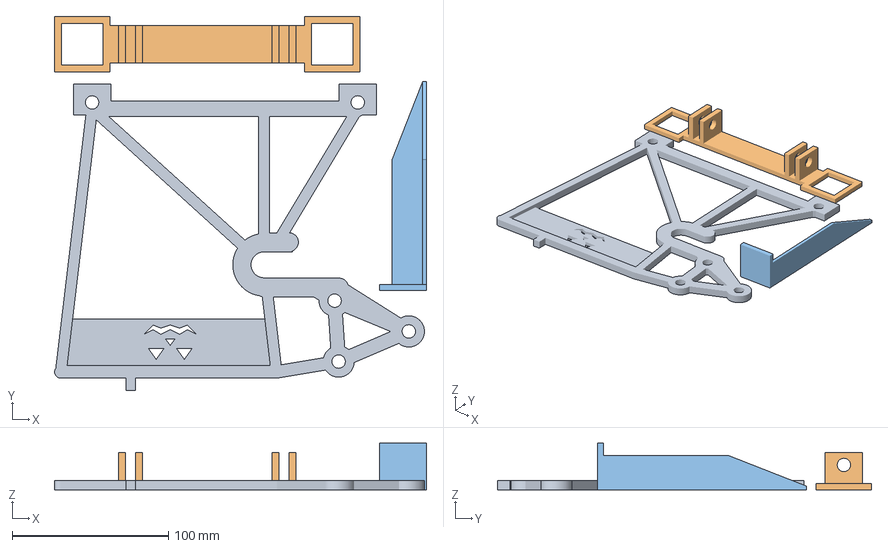
[picture p35: CAD file, 2026-10-14]
conveyor/plates/FINAL_06_head_side_b_etc.3mf
238.0 x 239.5 x 30.0 mm
head_side_b
foot
spike
