neilextraacount-create/holoween-shoot/conveyor/simple/stl/station_stake_3.stl

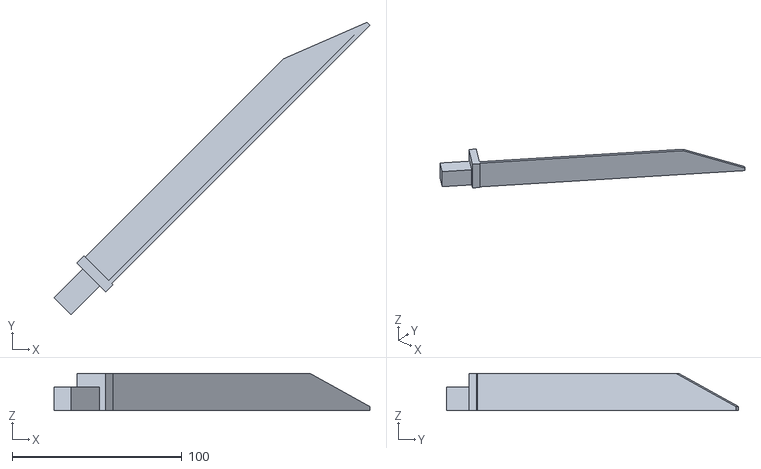
[picture p36: CAD file, 2026-10-15]
conveyor/simple/stl/station_stake_3.stl
186.0 x 172.1 x 22.0
