neilextraacount-create/holoween-shoot/conveyor/cad/stl/stake_2.stl

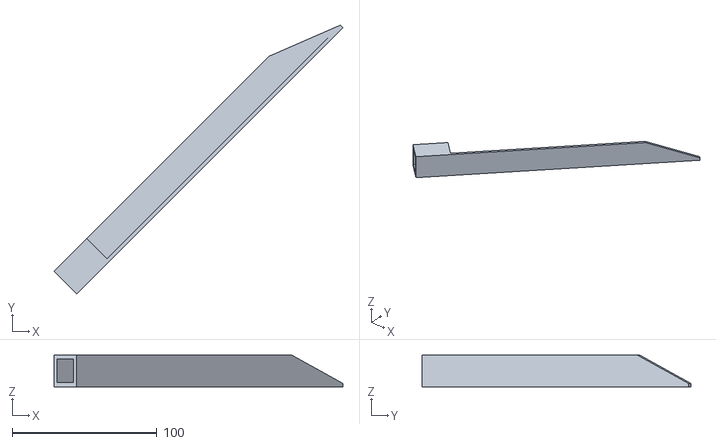
[picture p37: CAD file, 2026-10-14]
conveyor/cad/stl/stake_2.stl
199.4 x 185.5 x 22.0
