neilextraacount-create/holoween-shoot/conveyor/plates/FINAL_14_post_upper_etc.3mf

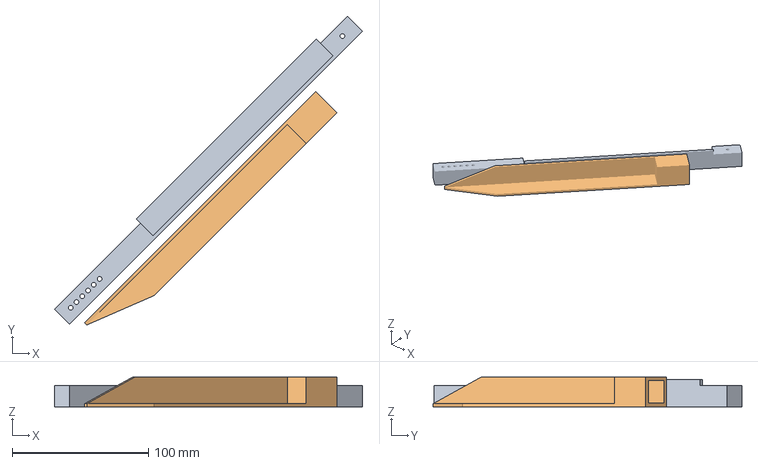
[picture p38: CAD file, 2026-10-14]
conveyor/plates/FINAL_14_post_upper_etc.3mf
226.0 x 226.7 x 22.0 mm
post_upper
stake_3
