neilextraacount-create/holoween-shoot/conveyor/simple/stl/station_stake_1.stl

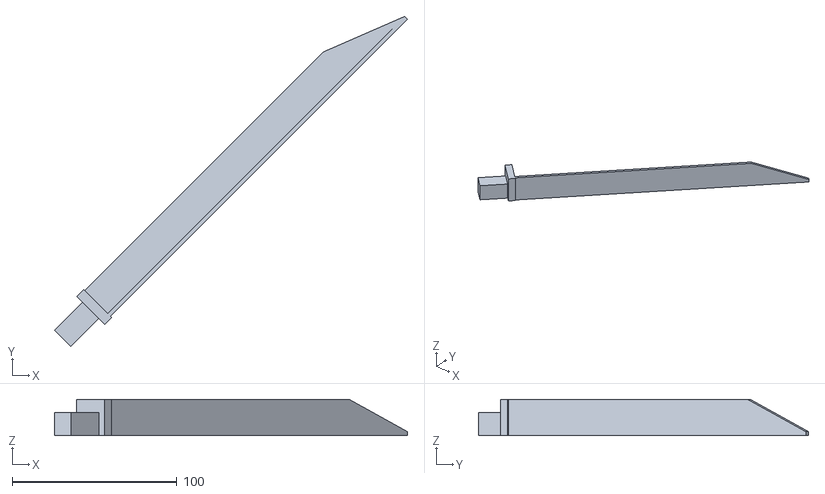
[picture p39: CAD file, 2026-10-15]
conveyor/simple/stl/station_stake_1.stl
214.3 x 200.4 x 22.0
