neilextraacount-create/holoween-shoot/conveyor/cad/stl/stand_tray.stl

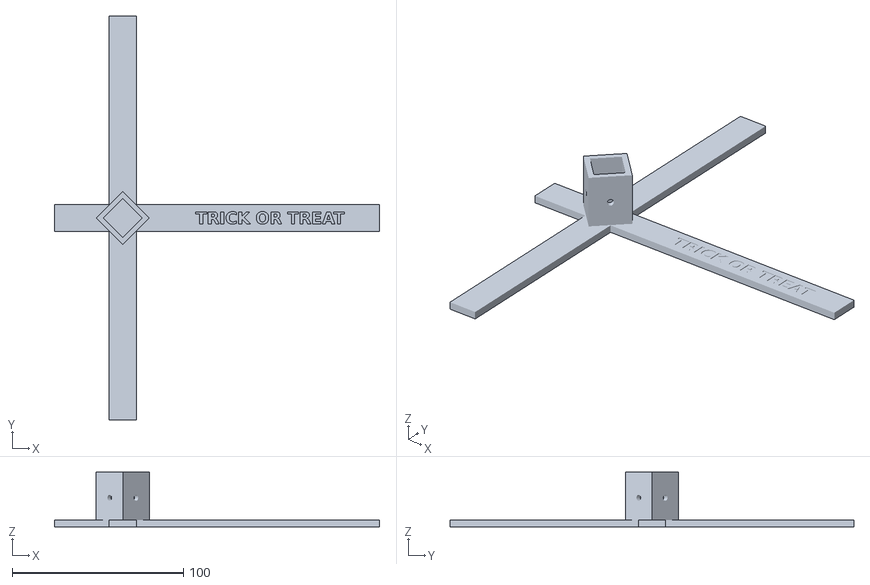
[picture p40: CAD file, 2026-10-14]
conveyor/cad/stl/stand_tray.stl
190.0 x 236.0 x 32.0
