neilextraacount-create/holoween-shoot/conveyor/plates/FINAL_05_gearbox_etc.3mf

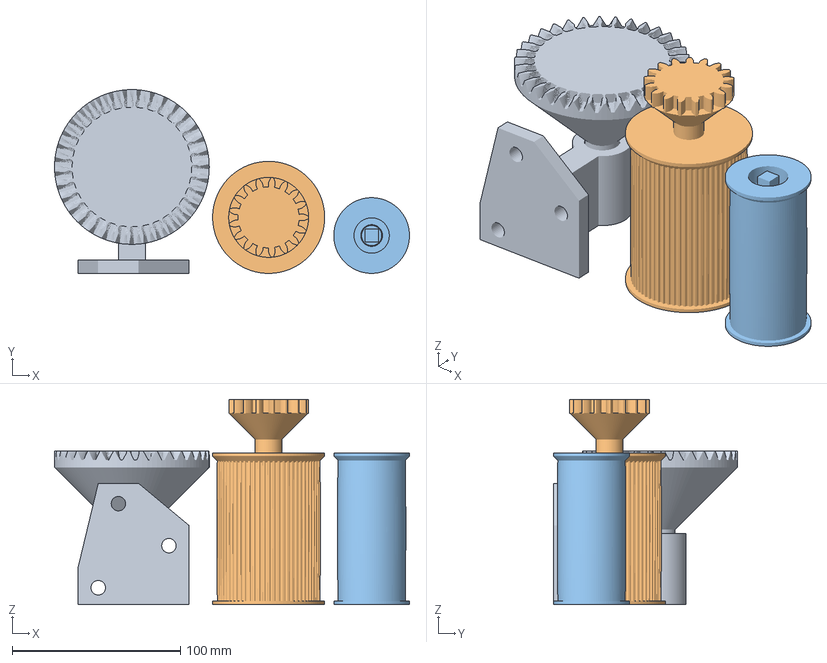
[picture p41: CAD file, 2026-10-14]
conveyor/plates/FINAL_05_gearbox_etc.3mf
211.0 x 109.3 x 121.9 mm
gearbox
drive_roller
tail_roller
