neilextraacount-create/holoween-shoot/conveyor/simple/stl/drive_roller.stl

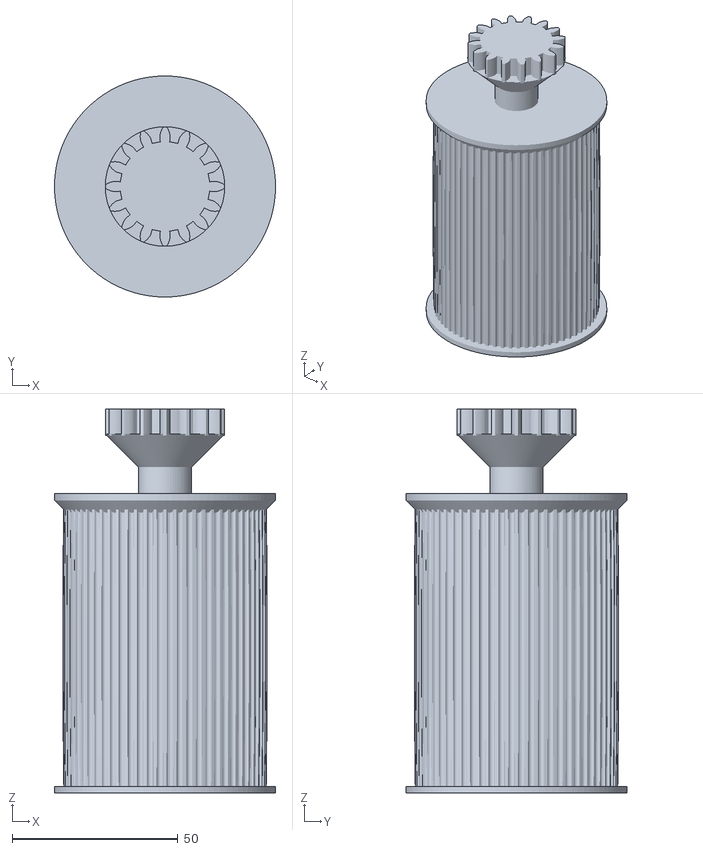
[picture p42: CAD file, 2026-10-15]
conveyor/simple/stl/drive_roller.stl
66.6 x 66.6 x 115.7
