neilextraacount-create/holoween-shoot/conveyor/cad/stl/head_side_b.stl

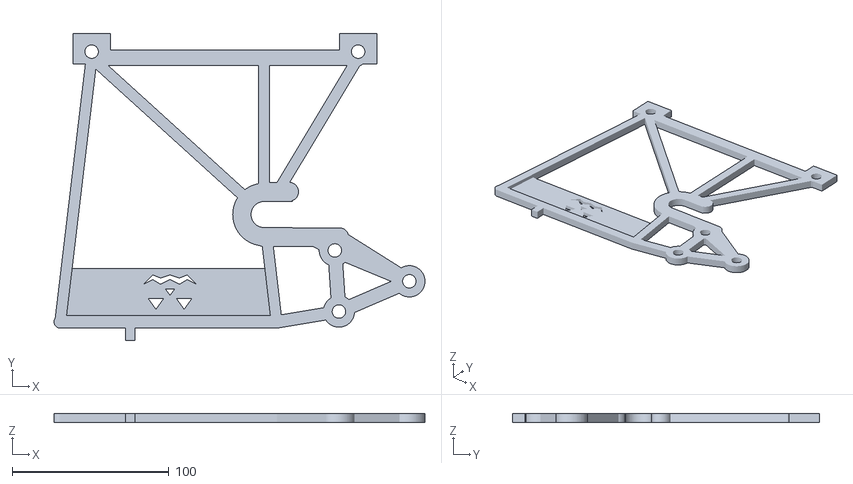
[picture p43: CAD file, 2026-10-14]
conveyor/cad/stl/head_side_b.stl
236.7 x 196.1 x 6.00
