neilextraacount-create/holoween-shoot/conveyor/simple/stl/tail_roller.stl

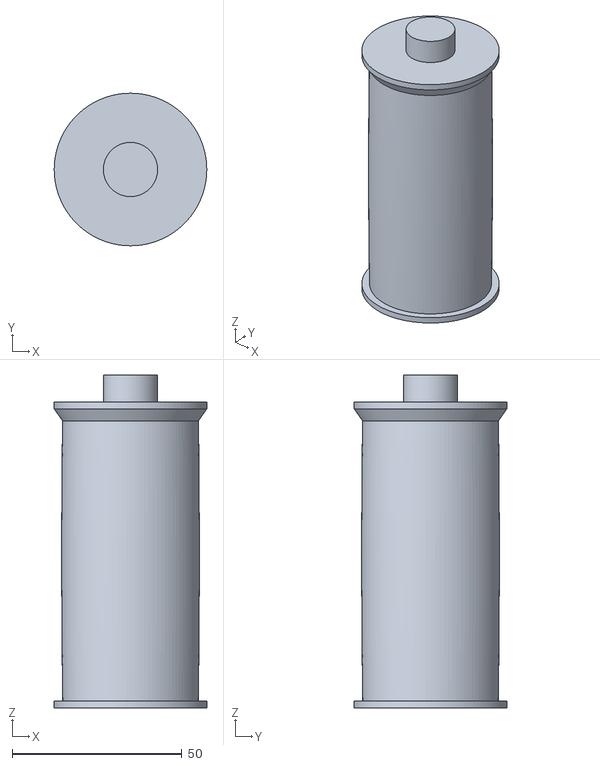
[picture p44: CAD file, 2026-10-15]
conveyor/simple/stl/tail_roller.stl
45.0 x 45.0 x 98.2
