neilextraacount-create/holoween-shoot/conveyor/cad/stl/head_side_a.stl

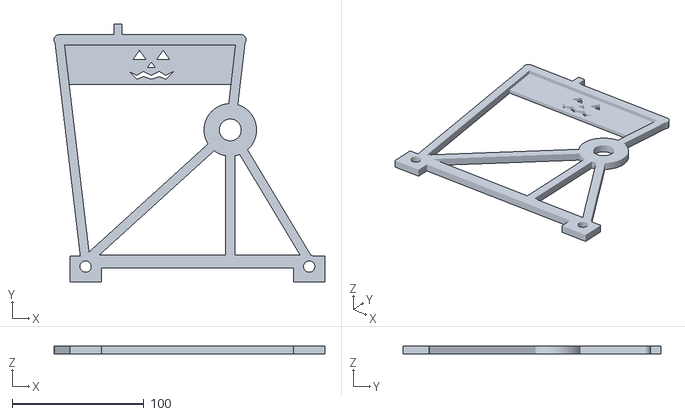
[picture p45: CAD file, 2026-10-14]
conveyor/cad/stl/head_side_a.stl
206.0 x 196.1 x 6.00
