neilextraacount-create/holoween-shoot/conveyor/plates/FINAL_07_wheel_unit.3mf

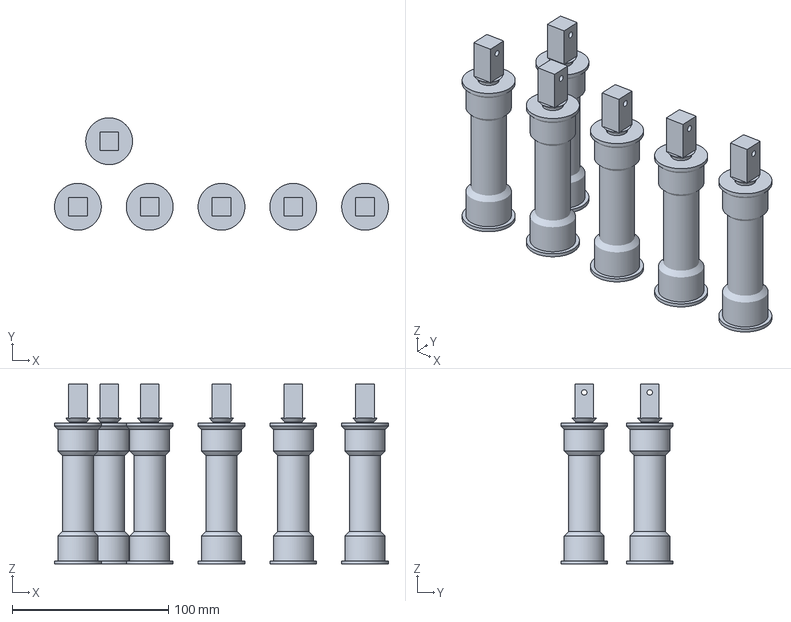
[picture p46: CAD file, 2026-10-14]
conveyor/plates/FINAL_07_wheel_unit.3mf
214.0 x 72.0 x 115.2 mm
wheel_unit x 6
