neilextraacount-create/holoween-shoot/conveyor/simple/stl/crank_gear.stl

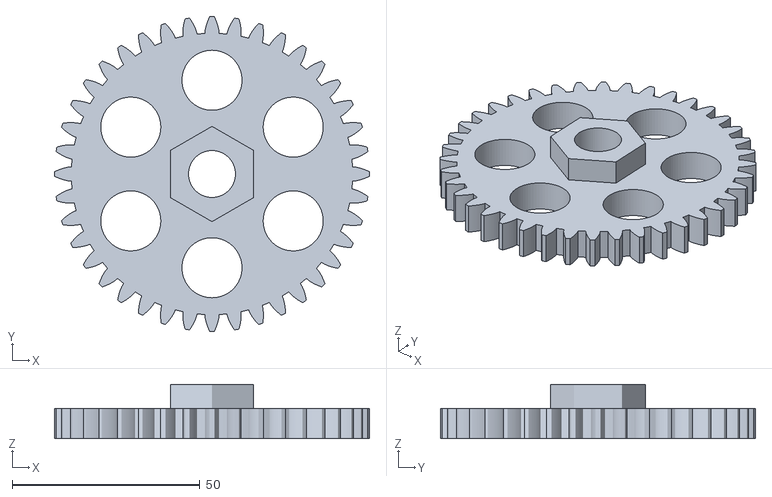
[picture p47: CAD file, 2026-10-15]
conveyor/simple/stl/crank_gear.stl
84.0 x 84.0 x 14.5
