neilextraacount-create/holoween-shoot/conveyor/cad/stl/wheel_unit.stl

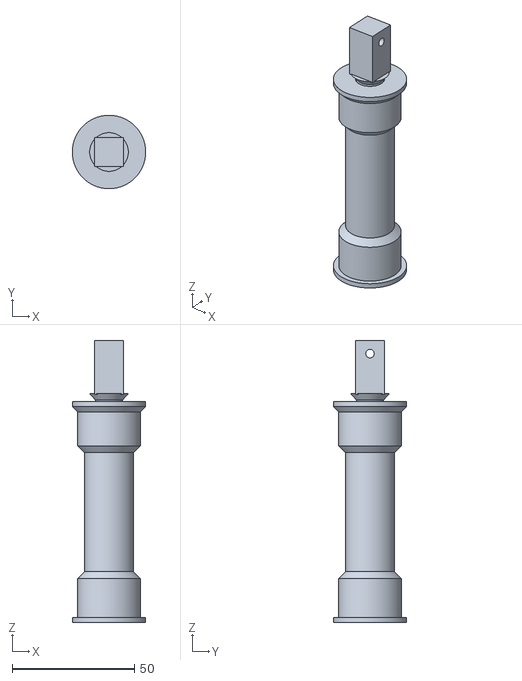
[picture p48: CAD file, 2026-10-14]
conveyor/cad/stl/wheel_unit.stl
30.0 x 30.0 x 115.2
