neilextraacount-create/holoween-shoot/conveyor/simple/stl/crank_pin.stl

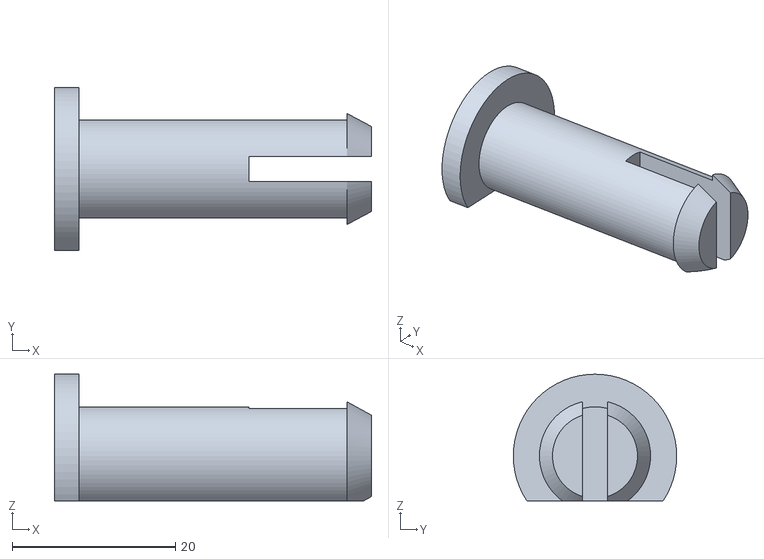
[picture p49: CAD file, 2026-10-15]
conveyor/simple/stl/crank_pin.stl
38.8 x 20.0 x 15.5
