neilextraacount-create/holoween-shoot/conveyor/cad/stl/splice_template.stl

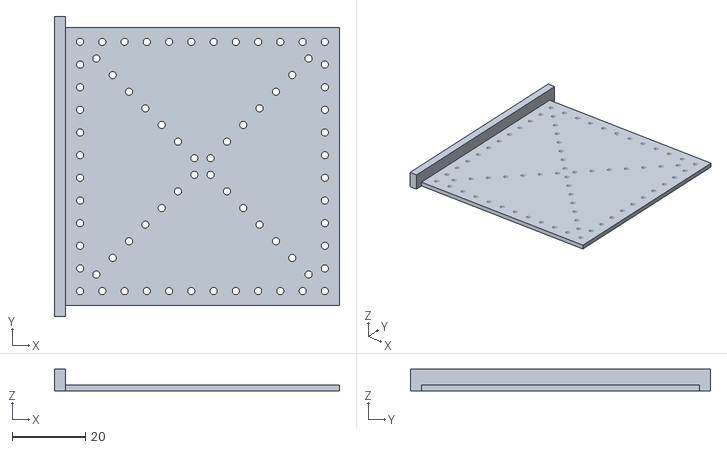
[picture p50: CAD file, 2026-10-14]
conveyor/cad/stl/splice_template.stl
78.0 x 82.2 x 6.00
