neilextraacount-create/holoween-shoot/conveyor/plates/FINAL_04_head_side_a_etc.3mf

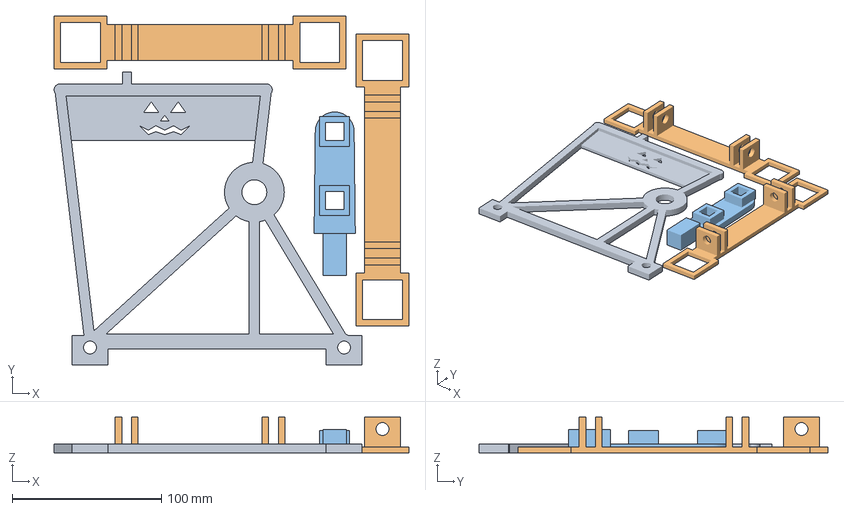
[picture p51: CAD file, 2026-10-14]
conveyor/plates/FINAL_04_head_side_a_etc.3mf
237.5 x 233.5 x 24.0 mm
head_side_a
foot x 2
station_bracket
