neilextraacount-create/holoween-shoot/conveyor/simple/stl/journal_pin.stl

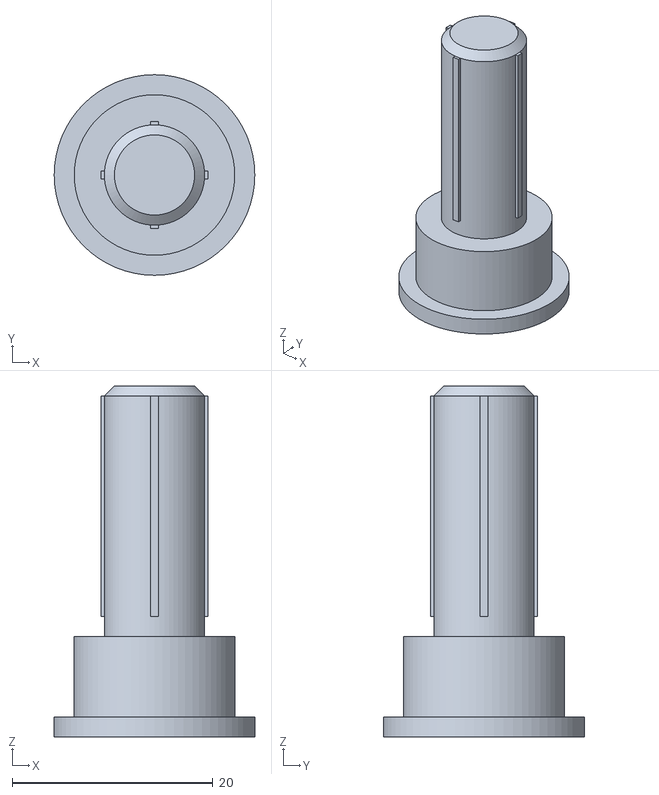
[picture p52: CAD file, 2026-10-14]
conveyor/simple/stl/journal_pin.stl
20.0 x 20.0 x 35.0
