neilextraacount-create/holoween-shoot/conveyor/cad/stl/test_coupon.stl

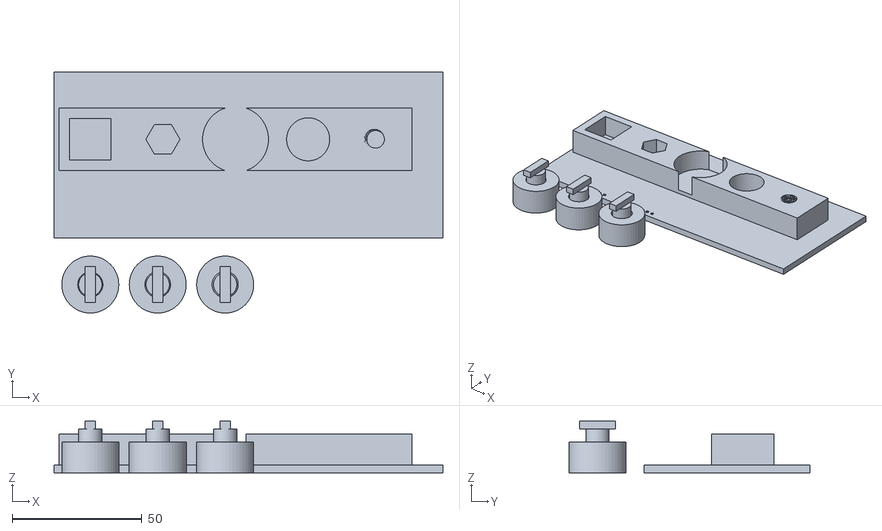
[picture p53: CAD file, 2026-10-14]
conveyor/cad/stl/test_coupon.stl
150.0 x 93.0 x 20.0
