neilextraacount-create/holoween-shoot/conveyor/plates/FINAL_13_gs_wrench_etc.3mf

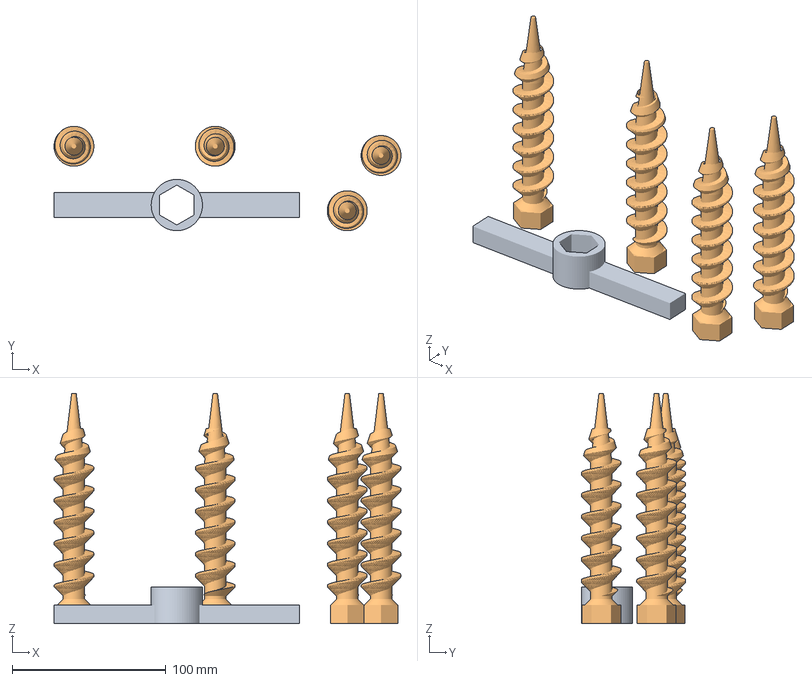
[picture p54: CAD file, 2026-10-14]
conveyor/plates/FINAL_13_gs_wrench_etc.3mf
226.0 x 68.0 x 150.0 mm
gs_wrench
ground_screw x 4
