neilextraacount-create/holoween-shoot/conveyor/plates/FINAL_12_skid_l_etc.3mf

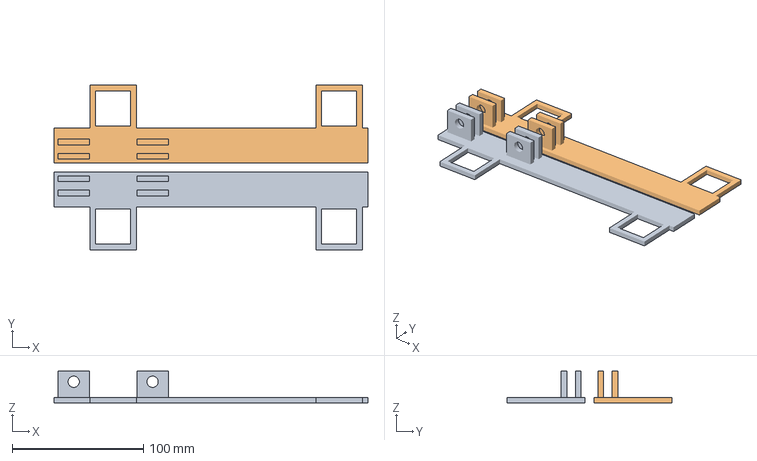
[picture p55: CAD file, 2026-10-14]
conveyor/plates/FINAL_12_skid_l_etc.3mf
239.0 x 125.3 x 24.0 mm
skid_l
skid_r
