neilextraacount-create/holoween-shoot/conveyor/cad/stl/trap.stl

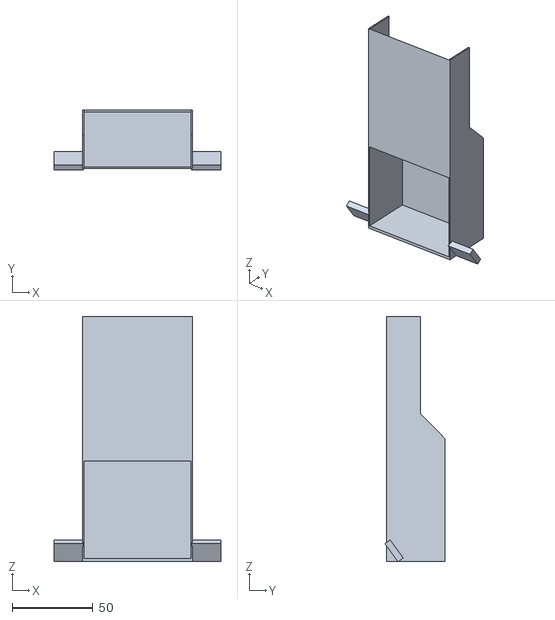
[picture p56: CAD file, 2026-10-14]
conveyor/cad/stl/trap.stl
103.2 x 37.2 x 151.5
