neilextraacount-create/holoween-shoot/conveyor/plates/FINAL_01_test_coupon_etc.3mf

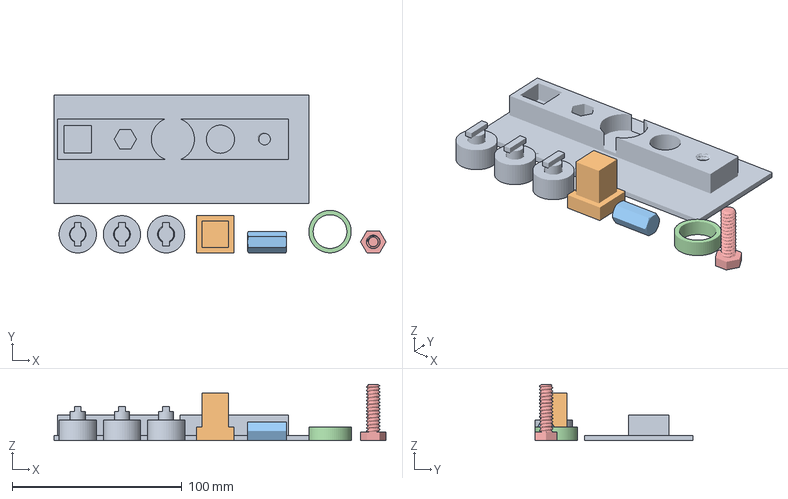
[picture p57: CAD file, 2026-10-14]
conveyor/plates/FINAL_01_test_coupon_etc.3mf
195.5 x 93.0 x 33.0 mm
test_coupon
stake_cap
hex_coupler
ring_sleeve
bolt8_28
