neilextraacount-create/holoween-shoot/conveyor/cad/stl/gs_wrench.stl

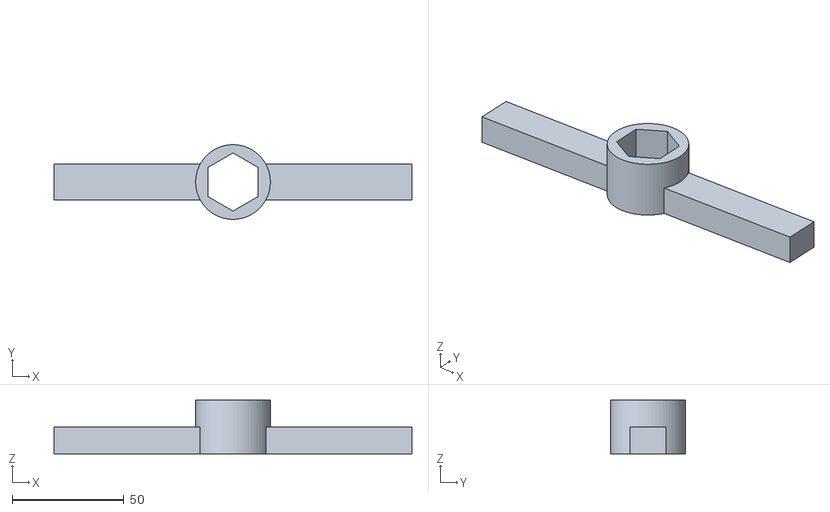
[picture p58: CAD file, 2026-10-14]
conveyor/cad/stl/gs_wrench.stl
160.0 x 33.4 x 24.0
