neilextraacount-create/holoween-shoot/conveyor/cad/stl/tail_side_r.stl

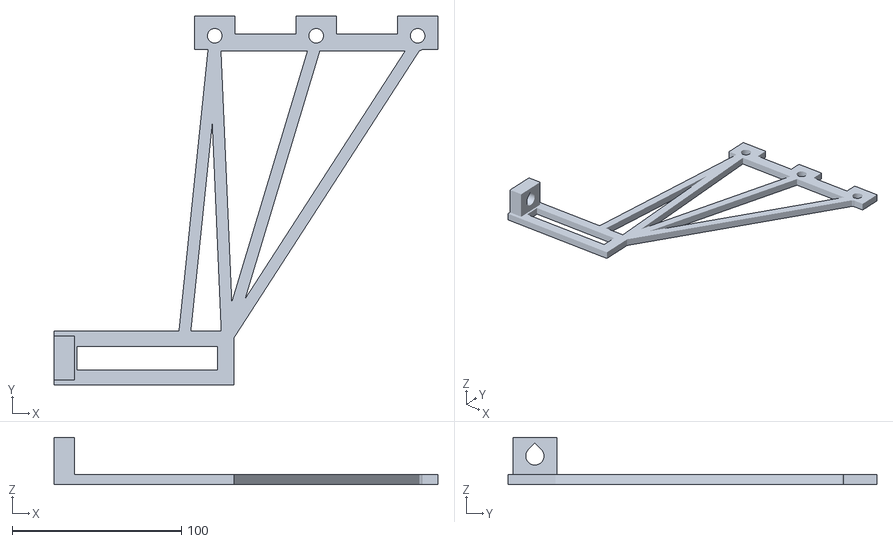
[picture p59: CAD file, 2026-10-14]
conveyor/cad/stl/tail_side_r.stl
227.0 x 218.2 x 28.0
