neilextraacount-create/holoween-shoot/conveyor/cad/stl/foot.stl

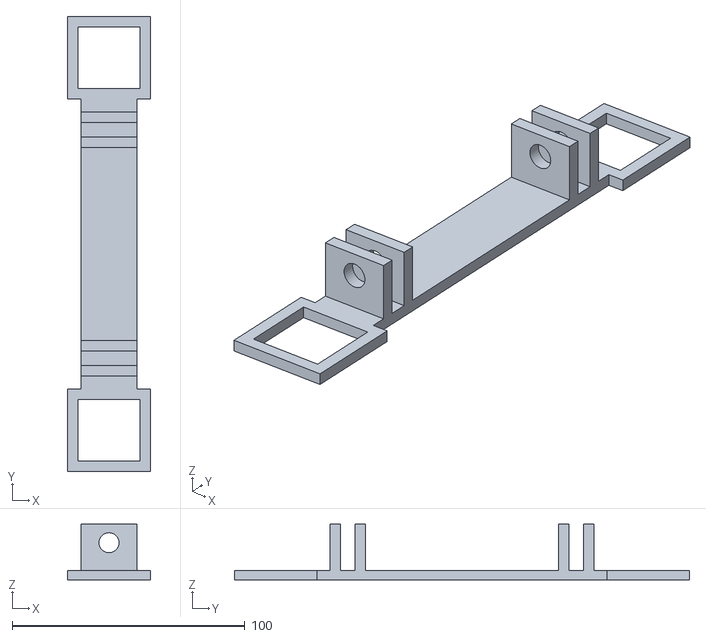
[picture p60: CAD file, 2026-10-14]
conveyor/cad/stl/foot.stl
35.5 x 195.5 x 24.0
