neilextraacount-create/holoween-shoot/conveyor/cad/stl/skid_r.stl

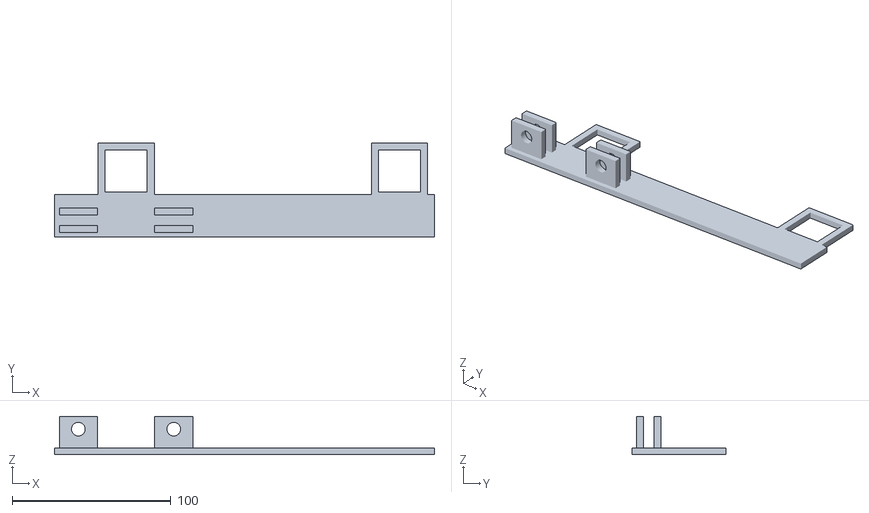
[picture p61: CAD file, 2026-10-14]
conveyor/cad/stl/skid_r.stl
239.0 x 59.3 x 24.0
