neilextraacount-create/holoween-shoot/conveyor/cad/stl/hex_coupler.stl

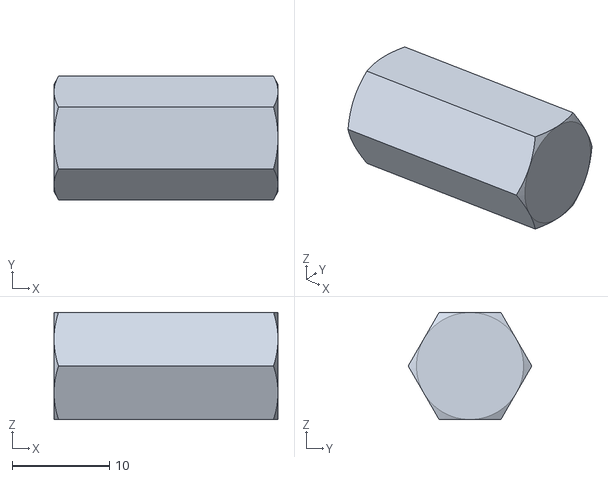
[picture p62: CAD file, 2026-10-14]
conveyor/cad/stl/hex_coupler.stl
23.0 x 12.7 x 11.0
