neilextraacount-create/holoween-shoot/conveyor/cad/stl/nut8.stl

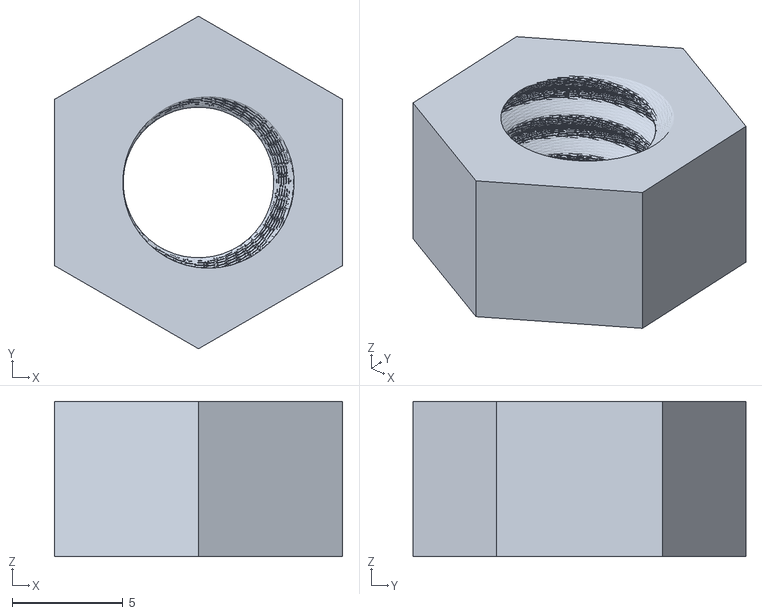
[picture p63: CAD file, 2026-10-14]
conveyor/cad/stl/nut8.stl
13.0 x 15.0 x 7.00
