neilextraacount-create/holoween-shoot/conveyor/cad/stl/pin3.stl

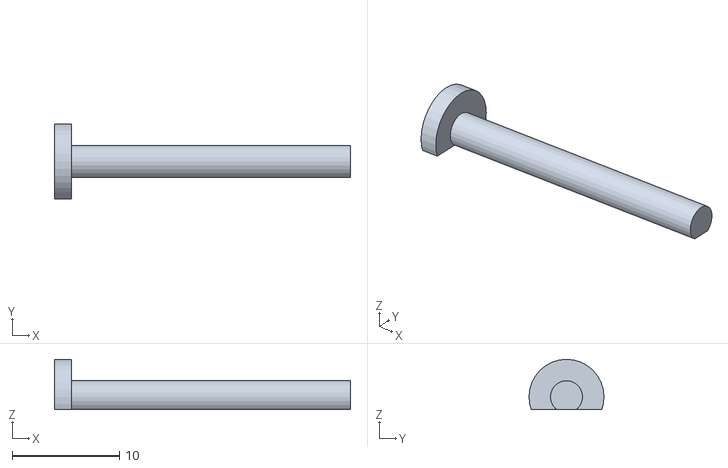
[picture p64: CAD file, 2026-10-14]
conveyor/cad/stl/pin3.stl
27.6 x 7.00 x 4.70
