neilextraacount-create/holoween-shoot/conveyor/cad/stl/stake_cap.stl

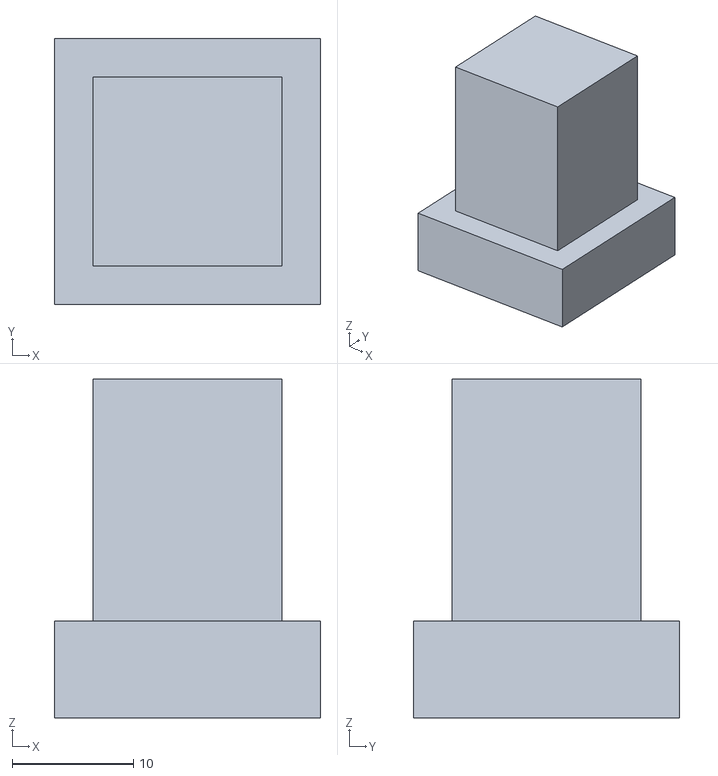
[picture p65: CAD file, 2026-10-14]
conveyor/cad/stl/stake_cap.stl
22.0 x 22.0 x 28.0
