neilextraacount-create/holoween-shoot/conveyor/cad/stl/post_lower.stl

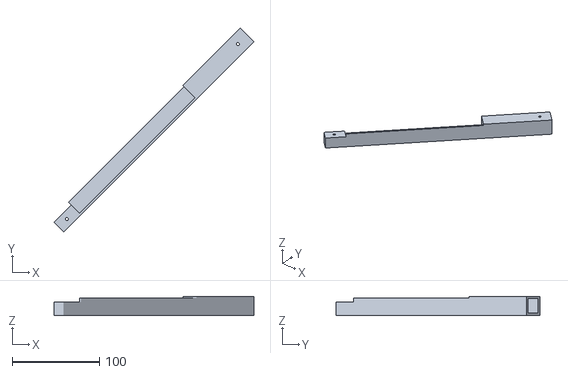
[picture p66: CAD file, 2026-10-14]
conveyor/cad/stl/post_lower.stl
228.8 x 233.3 x 22.0
