neilextraacount-create/holoween-shoot/conveyor/cad/stl/ring_sleeve.stl

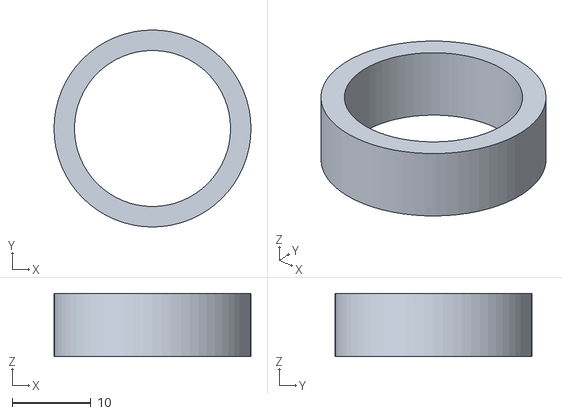
[picture p67: CAD file, 2026-10-14]
conveyor/cad/stl/ring_sleeve.stl
25.0 x 25.0 x 8.00
