neilextraacount-create/holoween-shoot/conveyor/cad/stl/tail_roller.stl

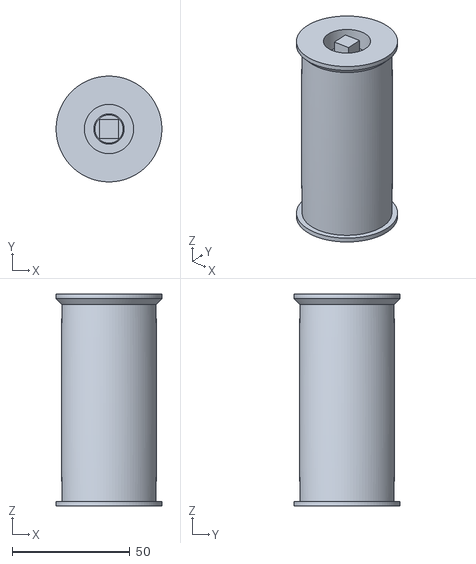
[picture p68: CAD file, 2026-10-14]
conveyor/cad/stl/tail_roller.stl
45.0 x 45.0 x 90.2
