neilextraacount-create/holoween-shoot/conveyor/cad/stl/post_upper.stl

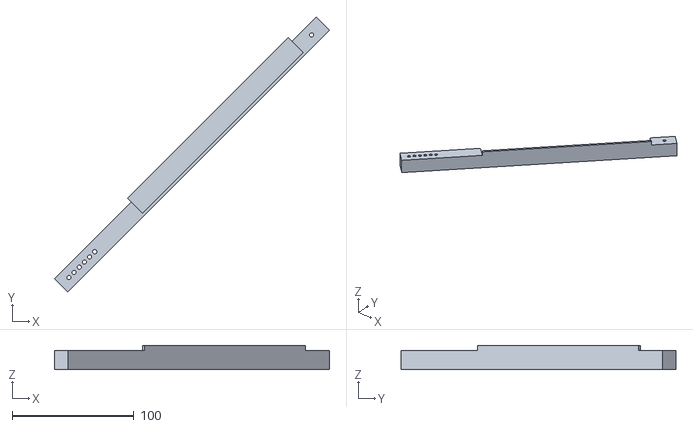
[picture p69: CAD file, 2026-10-14]
conveyor/cad/stl/post_upper.stl
226.0 x 226.0 x 20.0
