neilextraacount-create/holoween-shoot/conveyor/cad/stl/takeup_block.stl

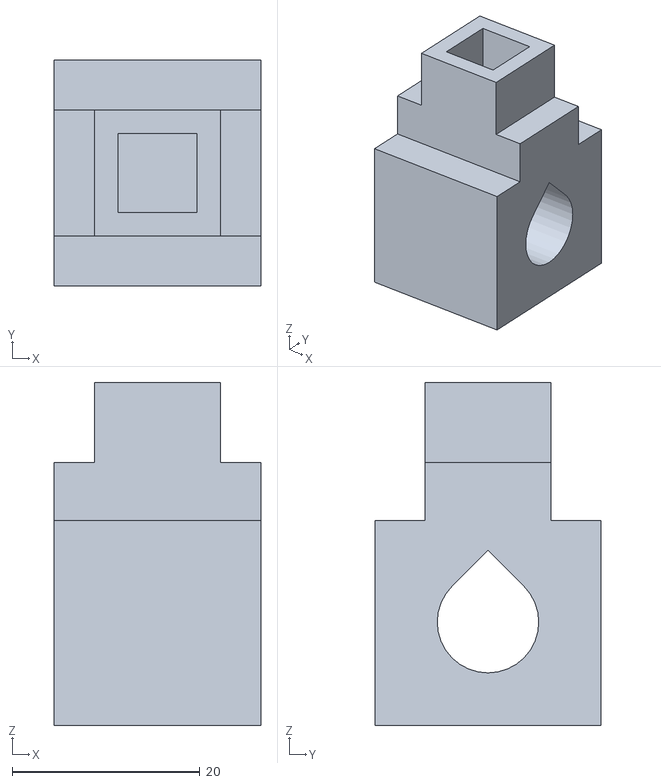
[picture p70: CAD file, 2026-10-14]
conveyor/cad/stl/takeup_block.stl
22.0 x 24.0 x 36.5
