neilextraacount-create/holoween-shoot/conveyor/cad/stl/station_bracket.stl

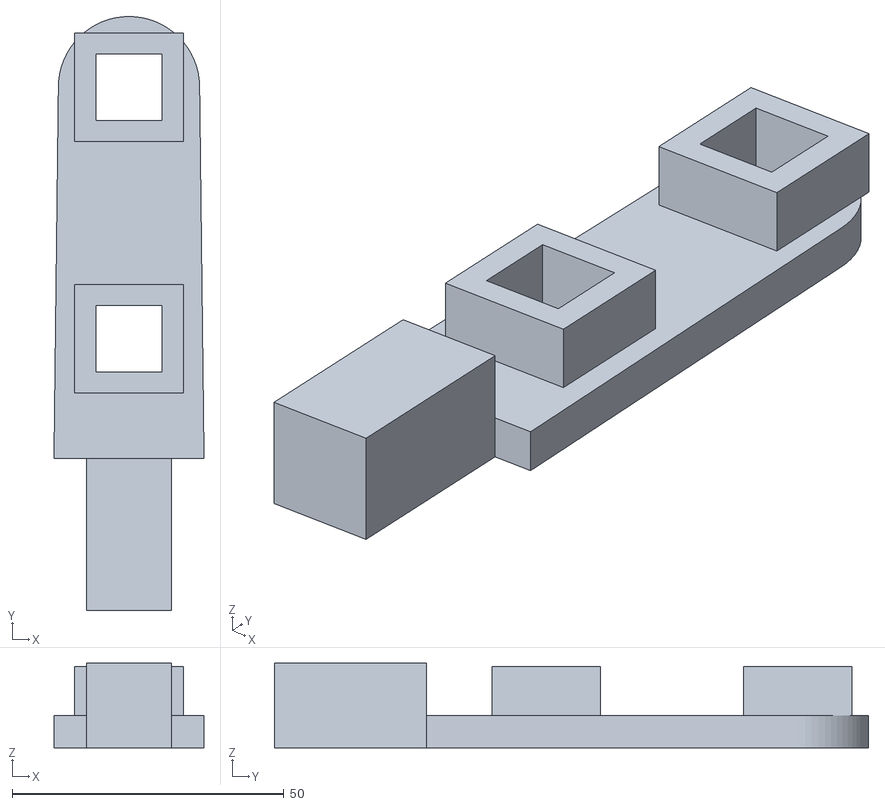
[picture p71: CAD file, 2026-10-14]
conveyor/cad/stl/station_bracket.stl
27.6 x 109.3 x 15.6
