neilextraacount-create/holoween-shoot/conveyor/cad/stl/stand_shim.stl

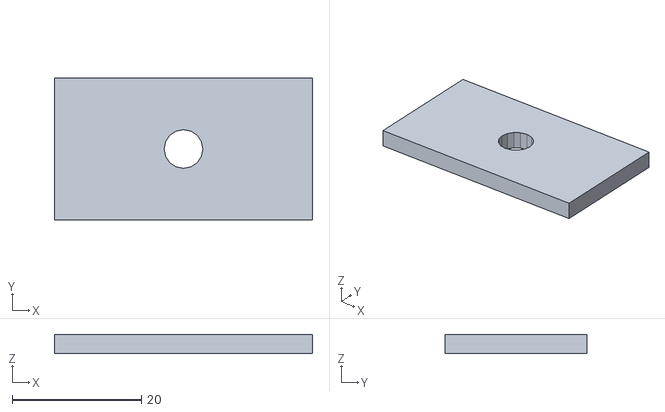
[picture p72: CAD file, 2026-10-14]
conveyor/cad/stl/stand_shim.stl
40.0 x 22.0 x 3.00
