neilextraacount-create/holoween-shoot/(list of files, cad)

Other CAD files:
conveyor/simple/stl/head_frame.stl
conveyor/cad/stl/crank_head.stl
conveyor/simple/stl/tail_frame.stl
conveyor/plates/FINAL_18_stand_tray.3mf
conveyor/cad/stl/skid_l.stl
conveyor/cad/stl/tail_side_l.stl
conveyor/cad/stl/bolt8_28.stl
conveyor/cad/stl/ground_screw.stl
conveyor/cad/stl/takeup_nut.stl
conveyor/cad/stl/takeup_screw.stl
conveyor/cad/stl/washer50.stl
conveyor/plates/FINAL_02_bolt8_28_etc.3mf
conveyor/plates/FINAL_03_washer50_etc.3mf
