neilextraacount-create/holoween-shoot/conveyor/cad/p2s-check.ini

# approximation of a Bambu Lab P2S, 0.4 nozzle, Bambu PLA Basic, textured PEI (for verification only)
bed_shape = 0x0,256x0,256x256,0x256
max_print_height = 256
nozzle_diameter = 0.4
filament_diameter = 1.75
filament_density = 1.24
filament_cost = 20
filament_max_volumetric_speed = 21
temperature = 220
first_layer_temperature = 220
bed_temperature = 55
first_layer_bed_temperature = 55
layer_height = 0.2
first_layer_height = 0.2
perimeters = 3
top_solid_layers = 5
bottom_solid_layers = 4
fill_density = 15%
fill_pattern = gyroid
support_material = 0
elefant_foot_compensation = 0.15
perimeter_generator = classic
extrusion_width = 0.42
first_layer_extrusion_width = 0.5
external_perimeter_extrusion_width = 0.42
perimeter_extrusion_width = 0.45
infill_extrusion_width = 0.45
solid_infill_extrusion_width = 0.42
top_infill_extrusion_width = 0.42
thin_walls = 0
extra_perimeters = 0
gcode_flavor = marlin2
binary_gcode = 0
skirts = 0
brim_width = 0
seam_position = aligned
thick_bridges = 0
overhangs = 1
external_perimeter_speed = 200
perimeter_speed = 300
small_perimeter_speed = 50%
infill_speed = 270
solid_infill_speed = 250
top_solid_infill_speed = 200
bridge_speed = 50
gap_fill_speed = 250
travel_speed = 500
first_layer_speed = 50
default_acceleration = 10000
perimeter_acceleration = 5000
infill_acceleration = 10000
bridge_acceleration = 5000
first_layer_acceleration = 500
travel_acceleration = 10000
machine_limits_usage = time_estimate_only
machine_max_acceleration_extruding = 20000
machine_max_acceleration_retracting = 5000
machine_max_acceleration_travel = 20000
machine_max_acceleration_x = 20000
machine_max_acceleration_y = 20000
machine_max_feedrate_x = 500
machine_max_feedrate_y = 500
machine_max_jerk_x = 9
machine_max_jerk_y = 9
retract_length = 0.8
gcode_comments = 0
gcode_label_objects = octoprint
