neilextraacount-create/holoween-shoot/(commit log)

2026-10-13 Add candy conveyor stage 1-2 analysis, architecture and calculator
    Claude-Session: https://claude.ai/code/session_01VeA1pUGvpRe2gDuWHwXtPJ
2026-10-13 Add part render and validation harness for conveyor CAD
    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
2026-10-13 Rework candy conveyor design: parametric CAD, v3 calculator, shopping list and guides (WIP)
    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
    [conveyor.scad, params.scad]
2026-10-13 v4 WIP: all-printed redesign (params, lib, first parts, calculator)
    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
    [conveyor.scad, lib.scad, params.scad]
2026-10-13 v4 WIP: tail module, gearbox crown generator, frame fixes
    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
    [conveyor.scad, params.scad]
2026-10-13 Candy conveyor v4: all-printed design, STLs, assembly checks, docs
    Everything except the belt is printed: stilt stations with print-in-place
    wheels, drive roller + crown-gear gearbox (teeth generated from the pinion
    motion), screw take-up tail, chute + print-in-place drive shaft over the
    steps, crank head with funnel, porch stand, printed fasteners and ground
    screws. check_parts.py renders every part and checks it (watertight, bodies,
    print-in-place gaps, bed fit, overhangs) and checks every mating pair in its
    assembled position; all checks pass.
    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
    [conveyor.scad, dump_vals.scad, lib.scad, params.scad]
2026-10-13 Add assembly pictures (head, station, tail, porch end) and the render script
    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
2026-10-13 Fix review findings, add the missing checks, commit the STL files
    Design fixes from the independent review (41 confirmed findings):
    - torque path: Ø18 shaft, 11 mm hex couplers, square crank drive
    - gearbox bolts fit; chute sockets lock each segment against turning
    - bearing rings carried by a tube instead of starting in mid-air
    - trap headroom 34 mm with a 60 mm slot
    - pinned, height-adjustable porch stand (tie it down or add 8 kg)
    - 100 g belt dip test (11-18 mm), thread_gap parameter, site parameters
    - tail roller flange cone was a loose sliver (self-intersecting profile)
    - crank grip now starts as a flat ring 2 layers above the arm
    New checks:
    - island check every 0.2 mm
    - coupler bite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
    [bolt8_28.stl, chute_segment.stl, conveyor.scad, crank_arm.stl, crank_head.stl, drive_pin.stl, drive_roller.stl, dump_vals.scad]
2026-10-13 Fix the second review's findings (stand, crank head foot, ballast, docs)
    An independent second review confirmed 18 issues:
    - Porch stand: the height joint now collapses 35 mm, so the stand fits under (and comes out from
    under) a crank head already on the line. Every pin hole is 15 mm from its shoulder, so two
    lower posts (tall porches) pin together. The checker models the stack and the collapse.
    - Crank head: a foot under the stand socket; it no longer starts from a 1 mm2 point.
    - Drive roller: the 0.3 mm crown is now real.
    - Bearing ring: the carrying tube now runs into the top ring.
    - Ballast: the calculator checks sliding (13 kg head / 8 kg tail on wet grass), so the guide now
    keeps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
    [chute_segment.stl, conveyor.scad, crank_arm.stl, crank_head.stl, drive_pin.stl, drive_roller.stl, foot.stl, ground_screw.stl]
2026-10-13 Stand collapses 35 mm from every height hole; take-down and anchoring steps fixed
    A focused review of the previous fixes confirmed 10 more issues:
    - Stand: the sliding joint is now 18 mm longer (pu_spig 89, socket 91 mm deep), so it collapses
    at least 35 mm from every height hole, including -12 and -18. The post lengths are
    unchanged. The checker now tests the collapse from the lowest hole.
    - Build guide:
    - pin the tray only after the long arm points onto the porch
    - prop the line before pulling the stand pins at take-down
    - separate anchoring cases (screw won't go in / spins / nothing can go in)
    - pin3 quantity follows post_n (2 lower posts need one more joint pin).
    - Stale text: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
    [bolt8_28.stl, chute_segment.stl, conveyor.scad, crank_arm.stl, crank_head.stl, drive_pin.stl, drive_roller.stl, dump_vals.scad]
2026-10-13 Print-ready plates and a real-slicer check of every part
    Build package:
    - plates/: 18 ready-arranged P2S build plates (3MF), grouped by print settings and in build
    order, each sliced as a whole to check it fits. The plate table (grams, time, settings) is
    written into the printing guide.
    - cad/slice_all.py: slices every part with PrusaSlicer (the engine Bambu Studio is built on)
    using a P2S-like profile (cad/p2s-check.ini) -> slice-report.md.
    - cad/gcode_gaps.py: print-in-place gaps measured in the sliced G-code: at least 0.43 mm
    between bodies, nothing printed onto another body -> gcode-gaps.md.
    - cad/gcode_support.py: traces the slicer's stability alerts to their spot in the G-code.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
    [01_test_coupon_etc.3mf, 02_bolt8_28_etc.3mf, 03_washer50_etc.3mf, 04_head_side_b_etc.3mf, 05_head_side_a_etc.3mf, 06_gearbox_etc.3mf, 07_wheel_unit.3mf, 08_tail_side_l_etc.3mf]
2026-10-13 Whole machine assembled on the site model, with overview pictures
    cad/full_assembly.py places the head, 4 stations, the tail, the chute line, crank and porch stand
    and the belt with the checker's own transforms on the lawn/sidewalk/step model. It checks ground
    contact (feet and skids within 2 mm, stakes 149-150 mm deep), that the belt rides every wheel
    and clears everything else by 8 mm, the return run's height above the lawn (87 mm), and the loop
    length (41.0 ft). Renders docs/img/full-machine.png and full-machine-side.png.
    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
    [dump_vals.scad]
2026-10-13 Fix the build-package review findings (plate builder, checks, guide)
    A final independent review of the print package confirmed 14 issues (1 major), all fixed:
    - README quick start now rebuilds the plates after the site is measured (plate files carry their
    own copies of the parts, so skipping it printed the old ones).
    - make_plates.py:
    - finds PrusaSlicer ($PRUSA_SLICER or the PATH), falling back to layout only (--no-slice)
    - creates its G-code folder
    - writes the new plates beside the old ones and swaps them in only when every plate is written
    and passes; a failed slice leaves plates/ and the guide unchanged and exits 1
    - checks that all plastic lies on the bed
    - keeps every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
    [p2s-check.ini]
2026-10-13 Regenerate plates, slicer report and gap report with the final tools
    - The 18 plates were re-sliced with the closer-to-Bambu profile: 2.65 kg in total. Every plate
    is on the bed, and the plate table now lists every alert group. The 3MF model contents are
    unchanged; the zips now have fixed timestamps.
    - The G-code gap check (0.30 mm rule) passes for all 7 print-in-place parts: 0.43-0.44 mm on
    the machine parts, 0.34 mm on the coupon's tightest spinner.
    - check_parts.py: all checks pass, and the plates match the STLs (no stale-plate note).
    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
    [01_test_coupon_etc.3mf, 02_bolt8_28_etc.3mf, 03_washer50_etc.3mf, 04_head_side_b_etc.3mf, 05_head_side_a_etc.3mf, 06_gearbox_etc.3mf, 07_wheel_unit.3mf, 08_tail_side_l_etc.3mf]
2026-10-13 Reproducible exports and the final acceptance fixes
    A final acceptance check (fresh-clone rebuild, bill of materials, print files) passed on all
    three lenses. Its loose ends are fixed:
    - STLs are written in a canonical triangle order, so the same part always gives the same bytes
    wherever the project is rebuilt. This removes a false "plates out of date" note and sub-mm
    layout shifts in a fresh clone.
    - 3MF vertices are written at full float32 precision (no welded zero-area triangles).
    - Plate 1 is marked as test only.
    - Shopping list: regenerate the plates after a belt-size change; the backup belt is 75 mm wide;
    the total is $83-125; a failed plate costs up to about 0.35 kg; "very likel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
2026-10-14 Regenerate STLs (canonical order), plates, slicer and gap reports; all checks pass
    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
    [01_test_coupon_etc.3mf, 02_bolt8_28_etc.3mf, 03_washer50_etc.3mf, 04_head_side_b_etc.3mf, 05_head_side_a_etc.3mf, 06_gearbox_etc.3mf, 07_wheel_unit.3mf, 08_tail_side_l_etc.3mf]
2026-10-14 Add LITE plates: fewer walls and less infill on lightly loaded parts (2.38 kg instead of 2.65 kg)
    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
    [LITE_01_test_coupon_etc.3mf, LITE_02_bolt8_28_etc.3mf, LITE_03_washer50_etc.3mf, LITE_04_head_side_b_etc.3mf, LITE_05_head_side_a_etc.3mf, LITE_06_gearbox_etc.3mf, LITE_07_wheel_unit.3mf, LITE_08_tail_side_l_etc.3mf]
2026-10-14 Final version: 2.28 kg (was 2.65), jack-o'-lantern guards, TRICK OR TREAT tray
    Walls and infill cut on every lightly loaded part after checking each against
    the load calc (rollers/gearbox/crank head 3 walls 10 %, frames 3 walls 12 %,
    chute 2 walls 10 %); crank arm, stake cap, ground screws, bolts, pins and
    couplers keep full strength. Chamfered the chute's top-web foot (removes the
    floating-bridge alert). Plates are now FINAL_NN_*.3mf (19 plates, ~71 h);
    the LITE set is removed. All part, slicer, G-code gap and full-assembly
    checks pass.
    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
    [01_test_coupon_etc.3mf, 02_bolt8_28_etc.3mf, 03_washer50_etc.3mf, 04_head_side_b_etc.3mf, 05_head_side_a_etc.3mf, 06_gearbox_etc.3mf, 07_wheel_unit.3mf, 08_tail_side_l_etc.3mf]
2026-10-14 Lighter design: 3 stations ~5 ft apart, thinner stakes, 8 mm gears, slim crank arm
    Source, STLs, calc and docs; plates are regenerated in the next commit.
    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
    [chute_segment.stl, conveyor.scad, crank_arm.stl, crank_head.stl, drive_roller.stl, dump_vals.scad, gearbox.stl, params.scad]
2026-10-14 Regenerate plates for the lighter design: 18 plates, 2.12 kg, about 67 h; all checks pass
    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
    [FINAL_02_bolt8_28_etc.3mf, FINAL_05_gearbox_etc.3mf, FINAL_06_head_side_b_etc.3mf, FINAL_07_wheel_unit.3mf, FINAL_08_tail_side_r_etc.3mf, FINAL_09_post_lower_etc.3mf, FINAL_09_tail_side_l_etc.3mf, FINAL_10_stake_1_etc.3mf]
2026-10-14 Wheels at 2 walls, ground screws and wrench at 3 walls 15 % (load-checked); computed wheel axle stress
    Plates are regenerated in the next commit.
    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
2026-10-14 Regenerate plates and reports: 18 plates, 2.03 kg, about 64 h; all checks pass
    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
2026-10-15 SIMPLE version: 21 printed parts, no bolts, crank at the foot of the steps
    New design in simple/: head frame with drop-in drive roller and a 2.5:1
    spur gear crank, tail frame with wedge take-up, 3 stations (stake +
    print-in-place wheel cassette), 4 anchor stakes. build.py checks every
    part (watertight, bed fit, overhangs, islands, print-in-place gaps), the
    gear mesh, every module assembly and the site layout; make.py slices
    every part and plate (6 plates, 1.19 kg) and checks the print-in-place
    gaps in the G-code. All checks pass.
    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
    [SIMPLE_01_wedge_etc.3mf, SIMPLE_02_tail_frame.3mf, SIMPLE_03_head_frame.3mf, SIMPLE_04_cassette_etc.3mf, SIMPLE_05_station_stake_1_etc.3mf, SIMPLE_06_anchor_stake.3mf, anchor_stake.stl, cassette.stl]
2026-10-16 SIMPLE: 0.88 kg, about 25 h (4 mm frame walls, lighter settings, slimmer station block, no tail panels); all checks pass
    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
    [SIMPLE_01_wedge_etc.3mf, SIMPLE_02_tail_frame.3mf, SIMPLE_03_head_frame.3mf, SIMPLE_04_cassette_etc.3mf, cassette.stl, head_frame.stl, simple.scad, tail_frame.stl]
